Eslam-Abdo/16-bit_microprocessor/ben eater/pc.docx

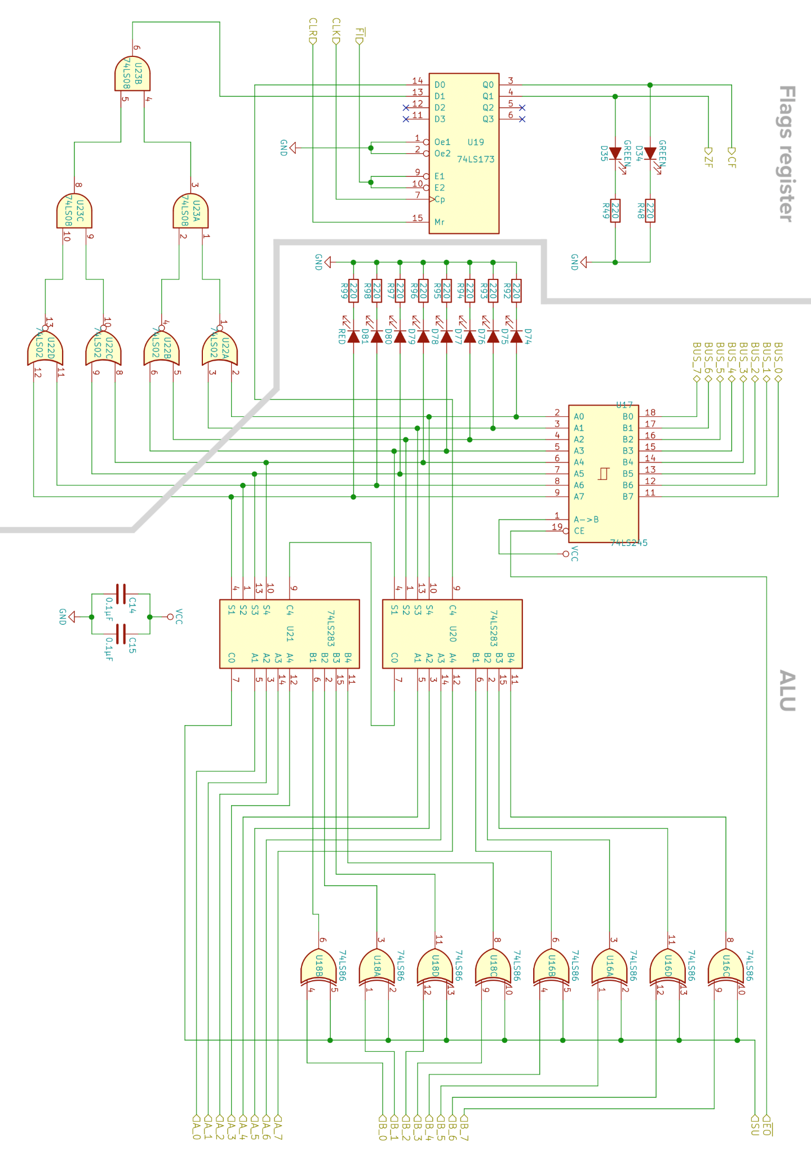
[picture p13: figure]
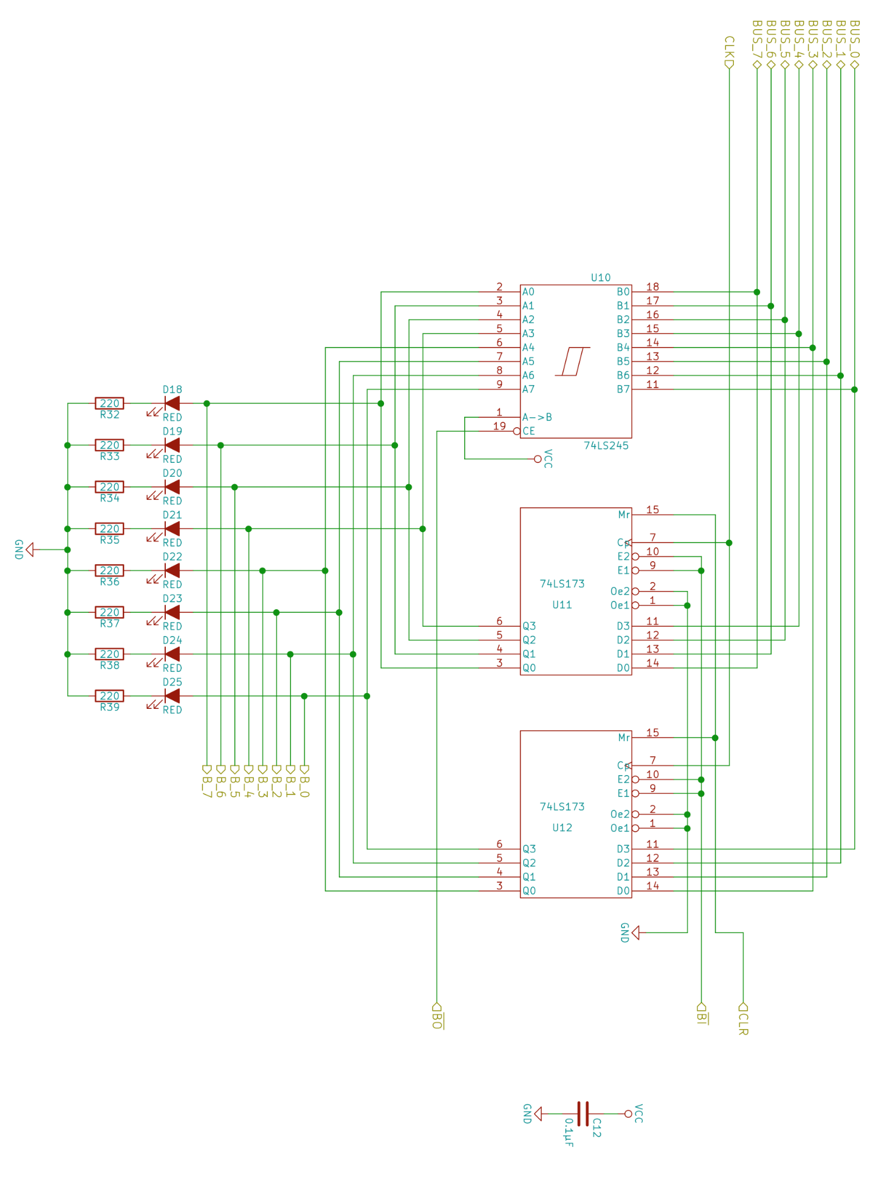
[picture p14: figure]
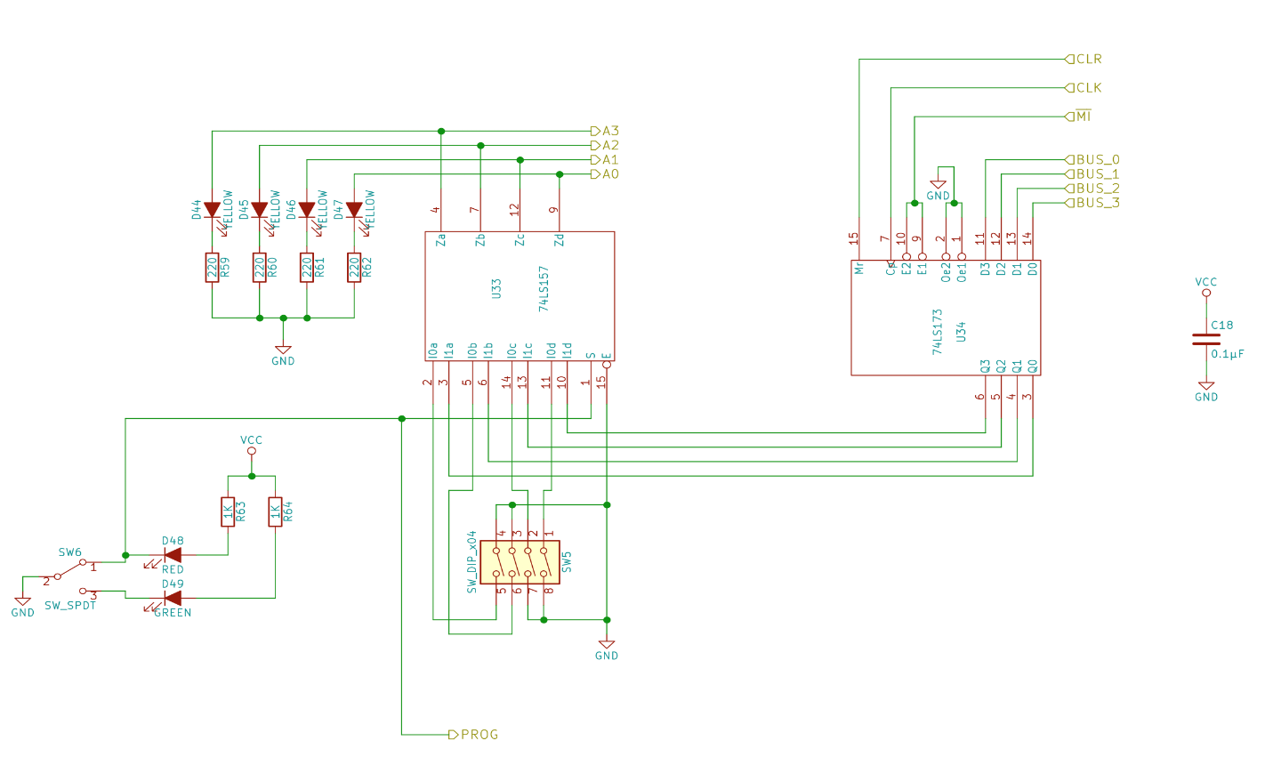
[picture p15: figure]
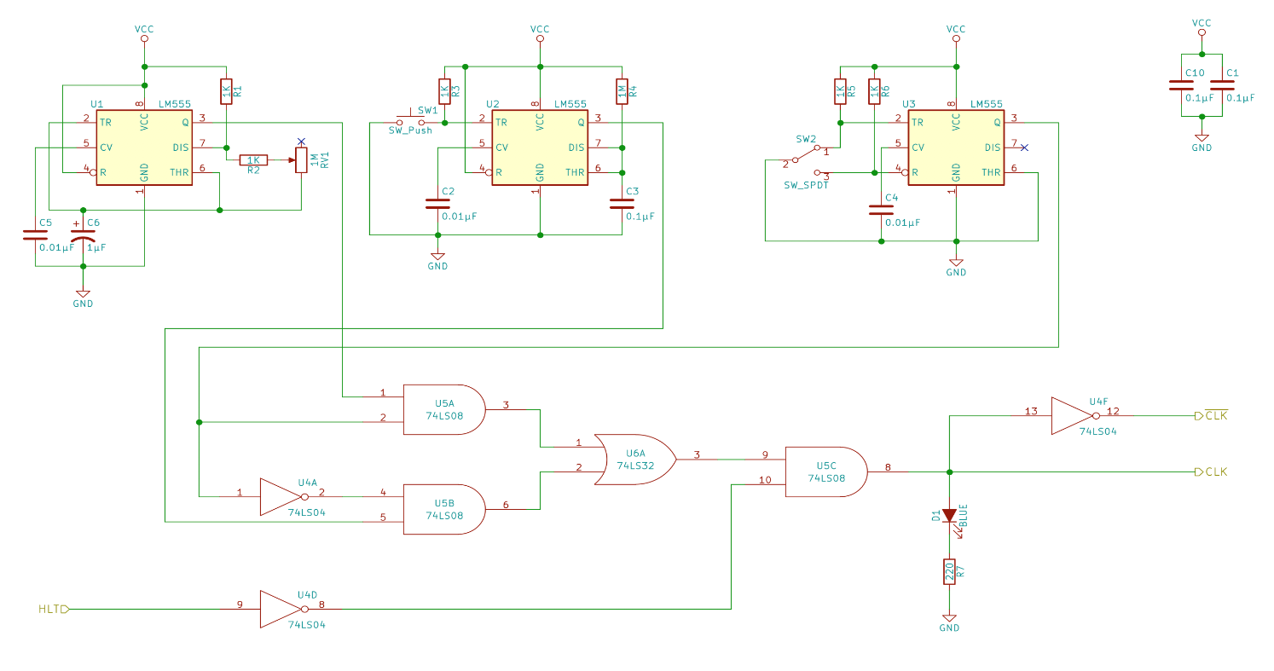
[picture p16: figure]
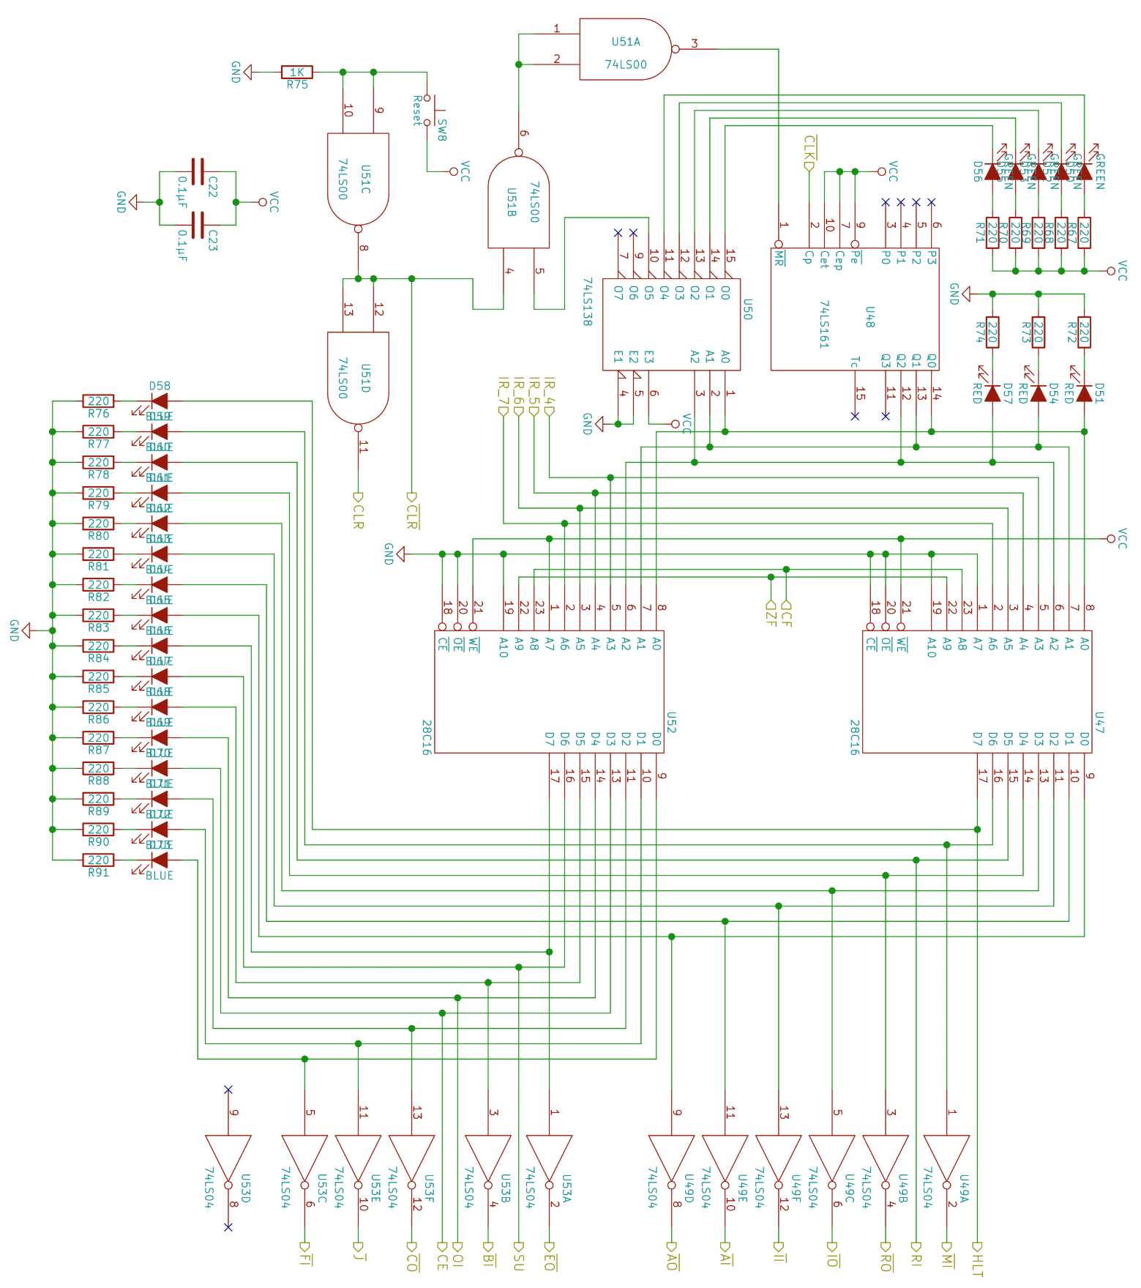
[picture p17: figure]
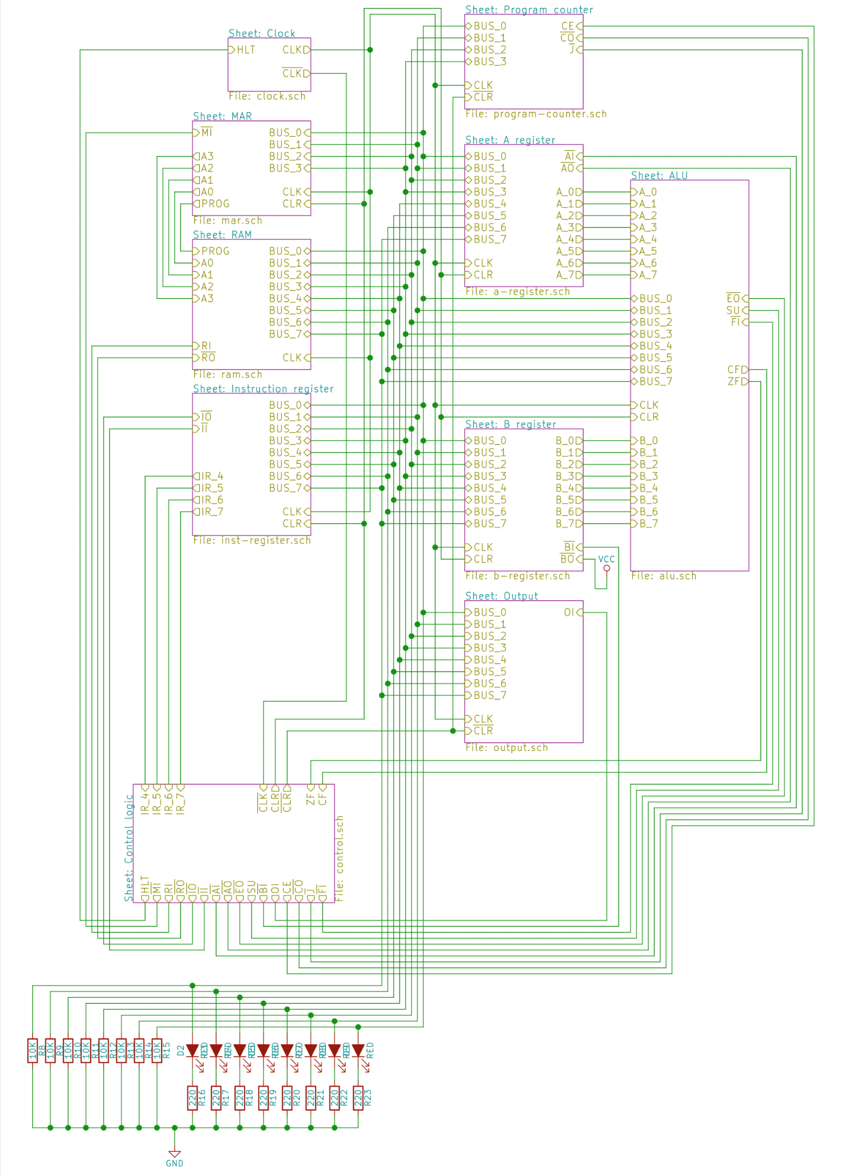
[picture p18: figure]
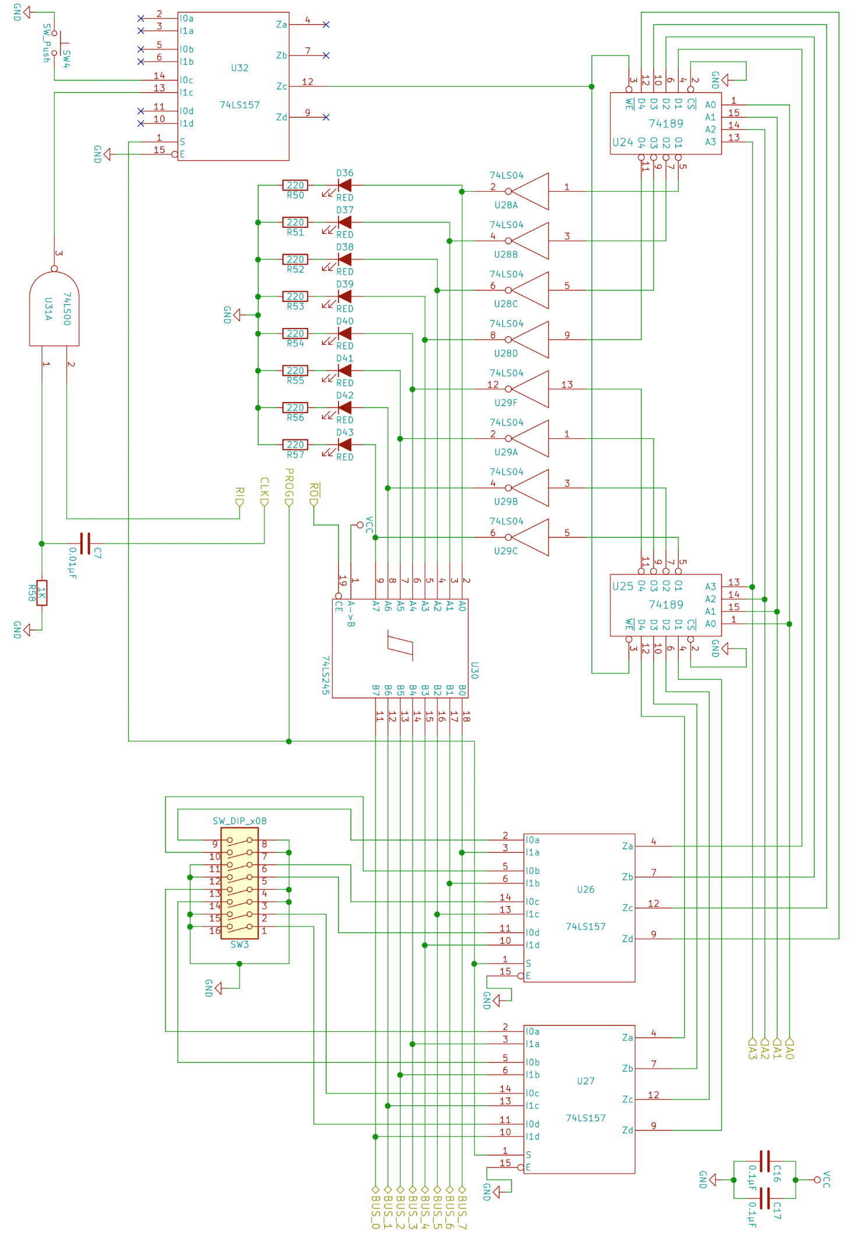
[picture p19: figure]
