Eslam-Abdo/16-bit_microprocessor/PDF/A+B.pdf

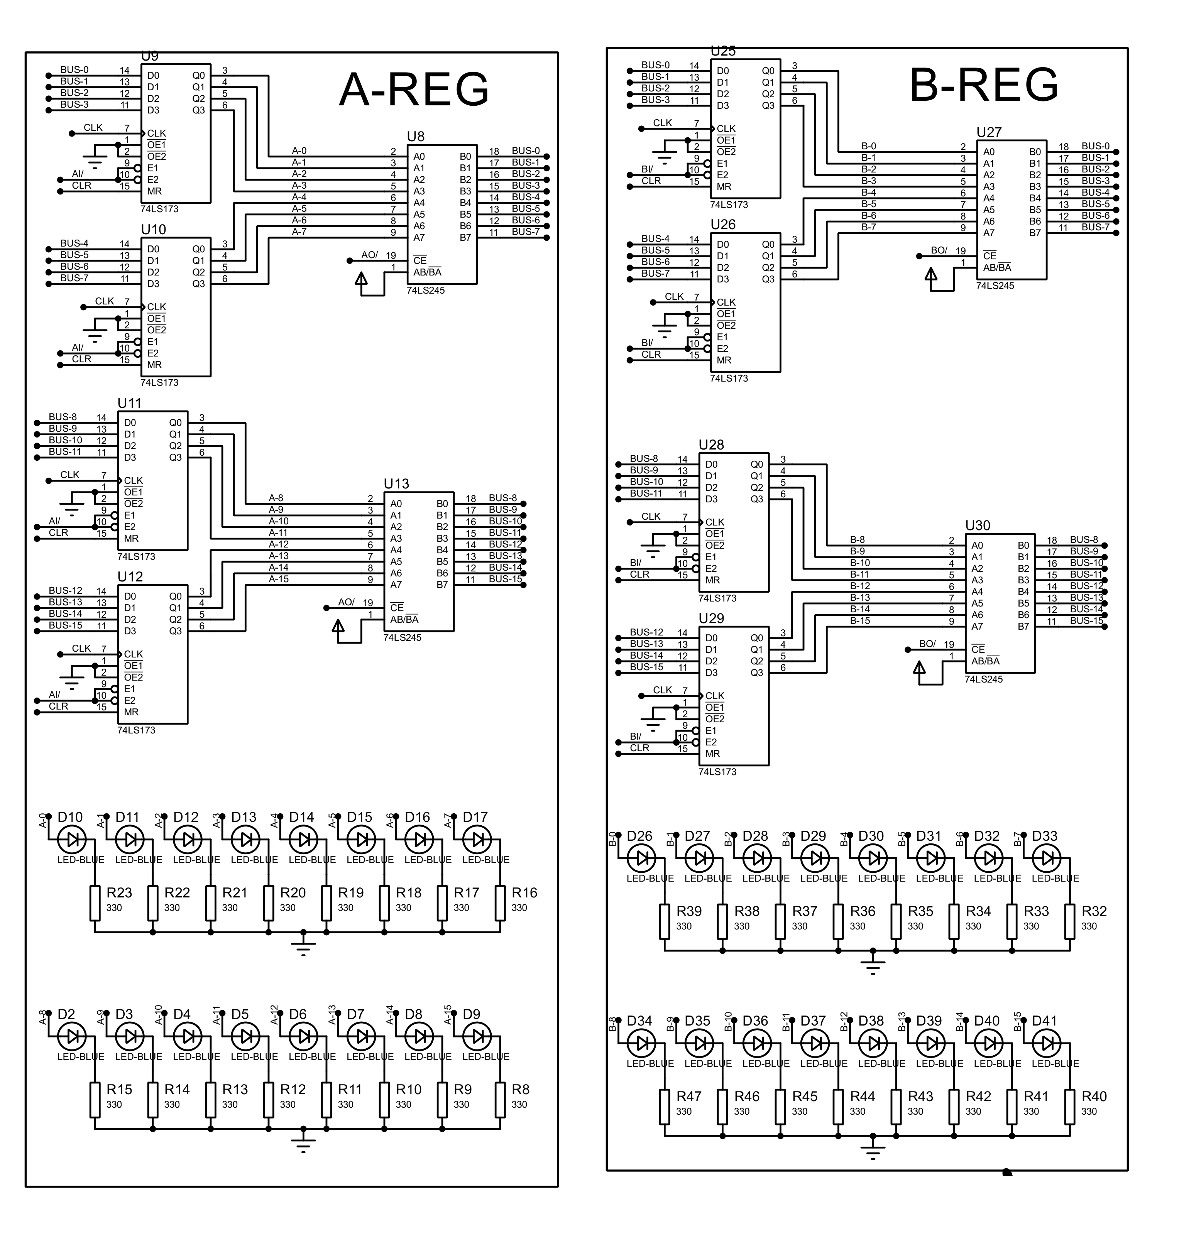
[picture p39: page 1]
