Eslam-Abdo/16-bit_microprocessor/PDF/A-REG.pdf

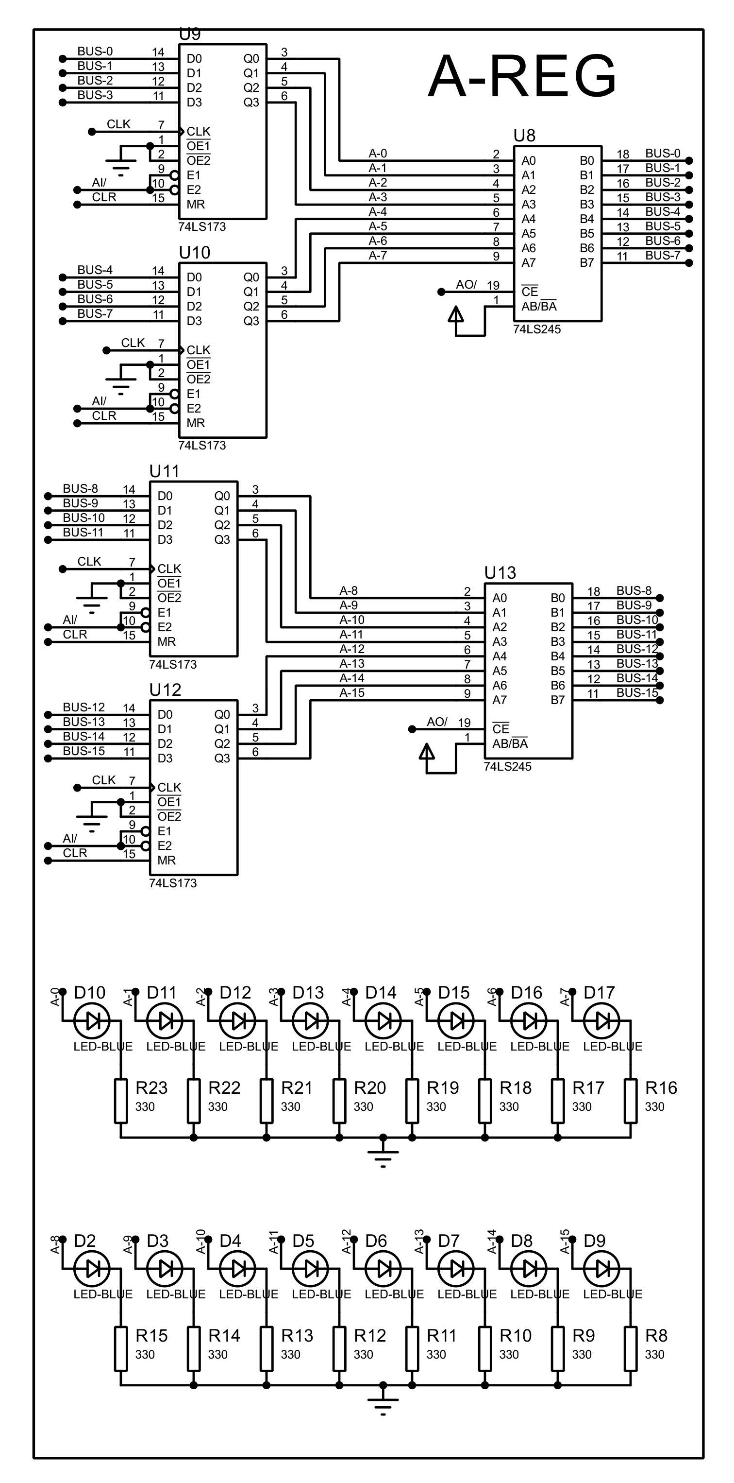
[picture p40: page 1]
