Eslam-Abdo/16-bit_microprocessor/PDF/ALU.pdf

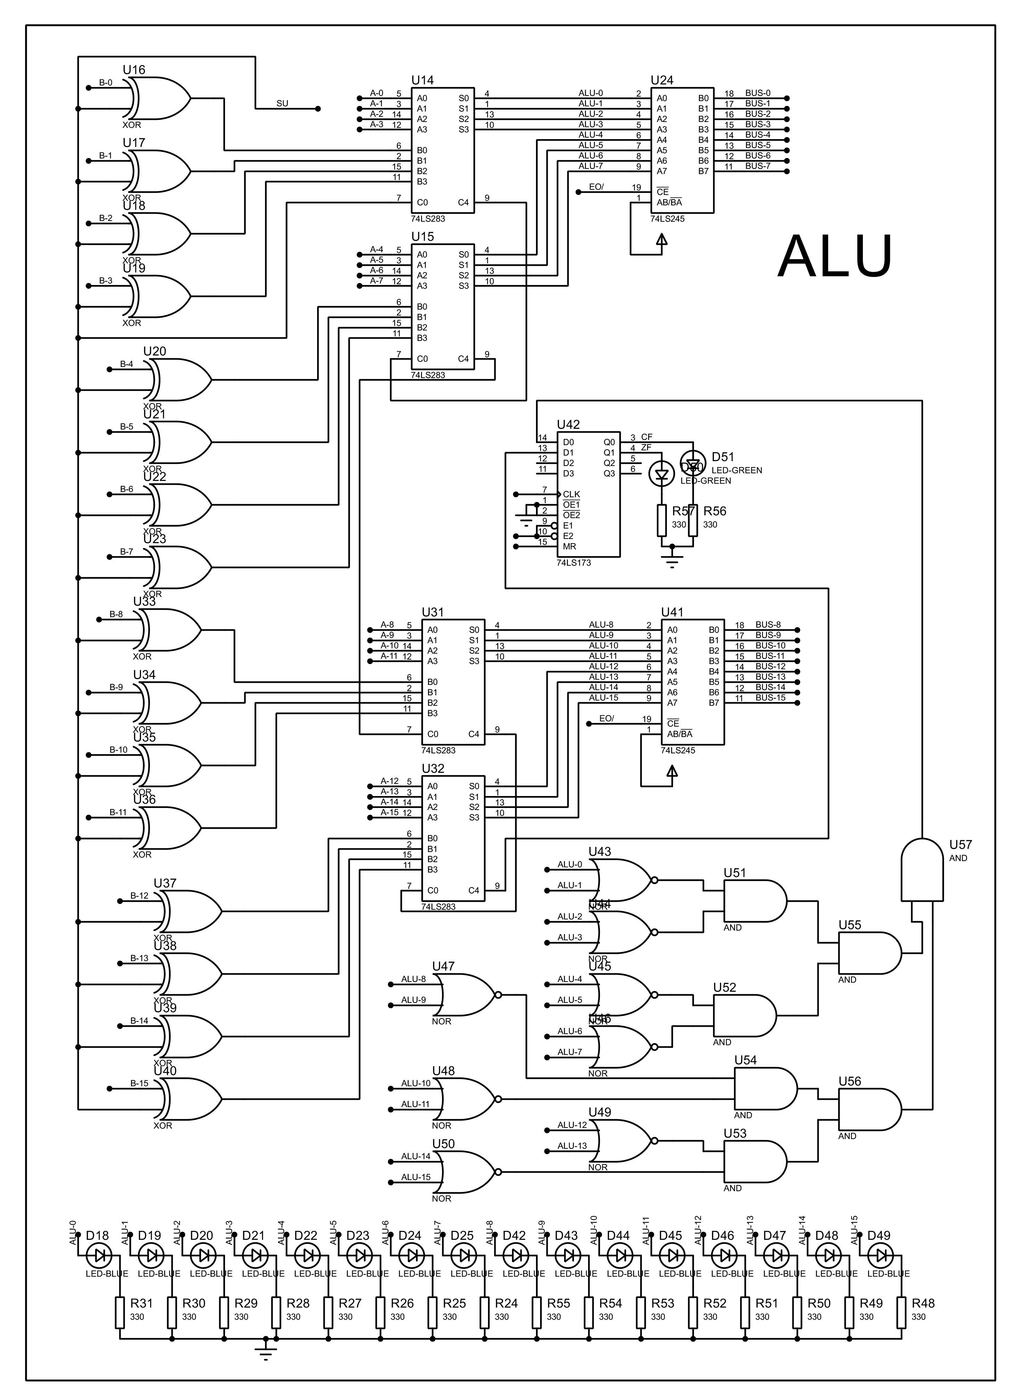
[picture p41: page 1]
