Eslam-Abdo/16-bit_microprocessor/PDF/B-REG.pdf

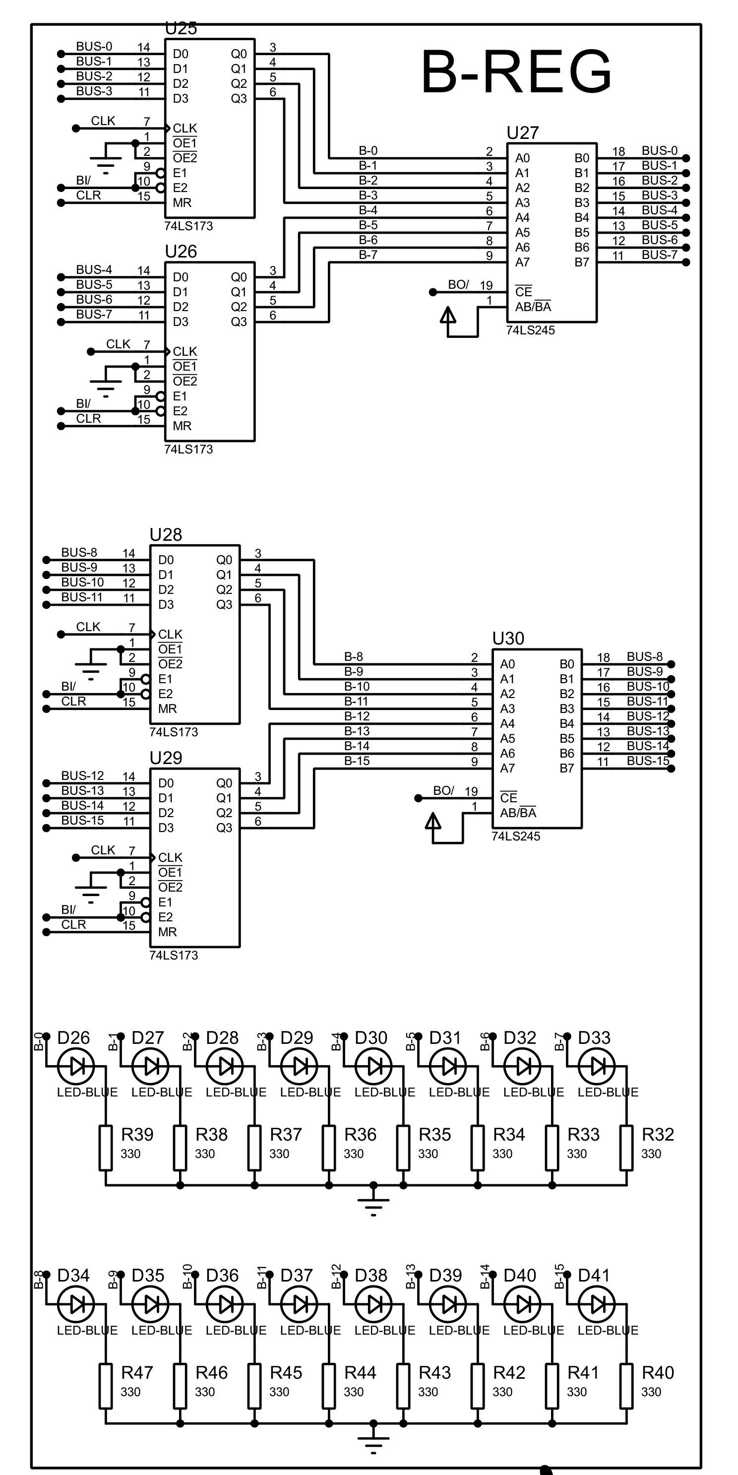
[picture p42: page 1]
