Eslam-Abdo/16-bit_microprocessor/PDF/BUS.pdf

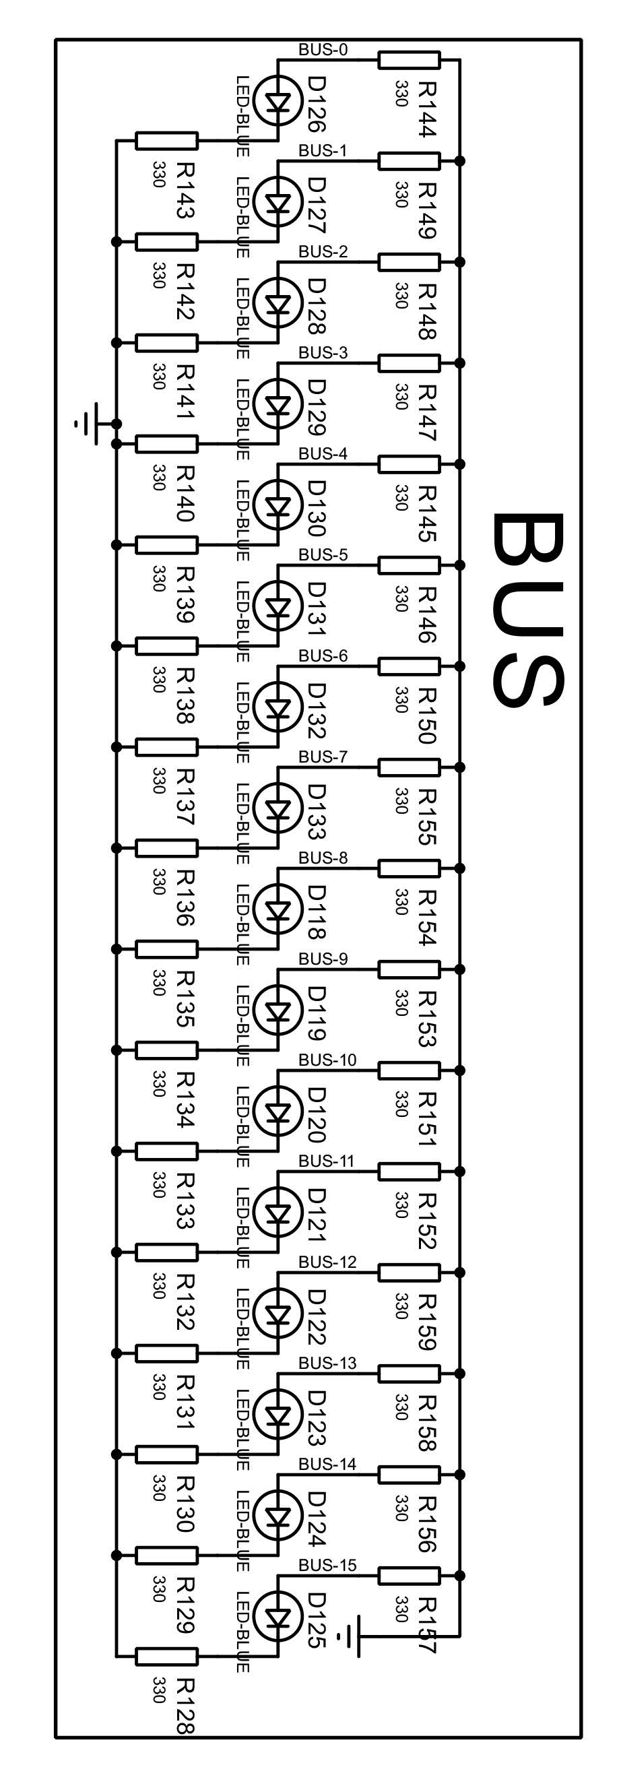
[picture p43: page 1]
