Eslam-Abdo/16-bit_microprocessor/PDF/cl+bus.pdf

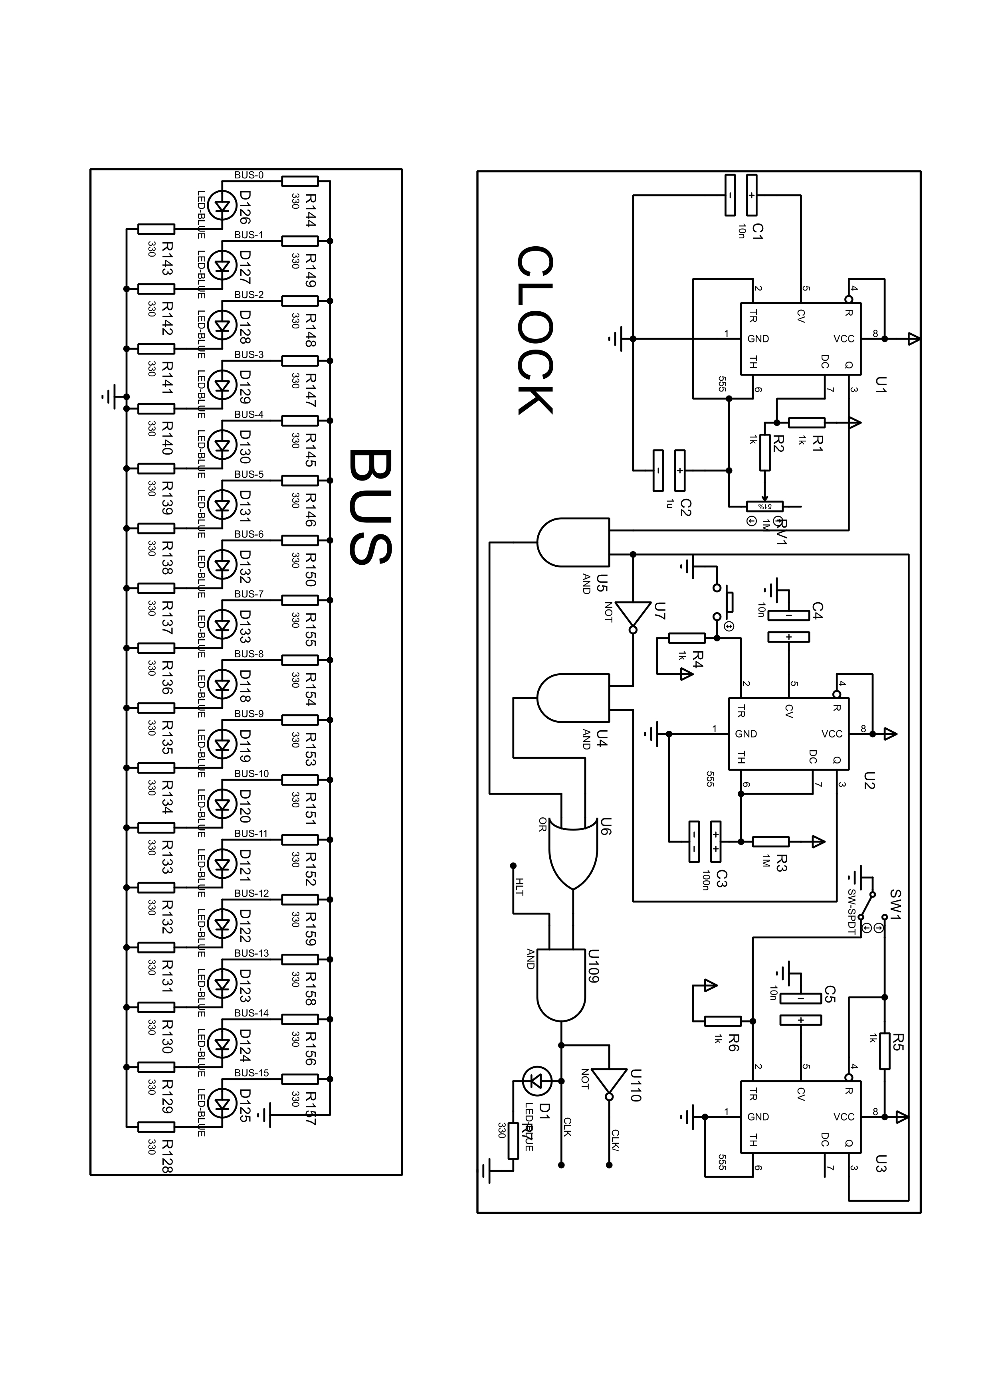
[picture p44: page 1]
