Eslam-Abdo/16-bit_microprocessor/PDF/clock.pdf

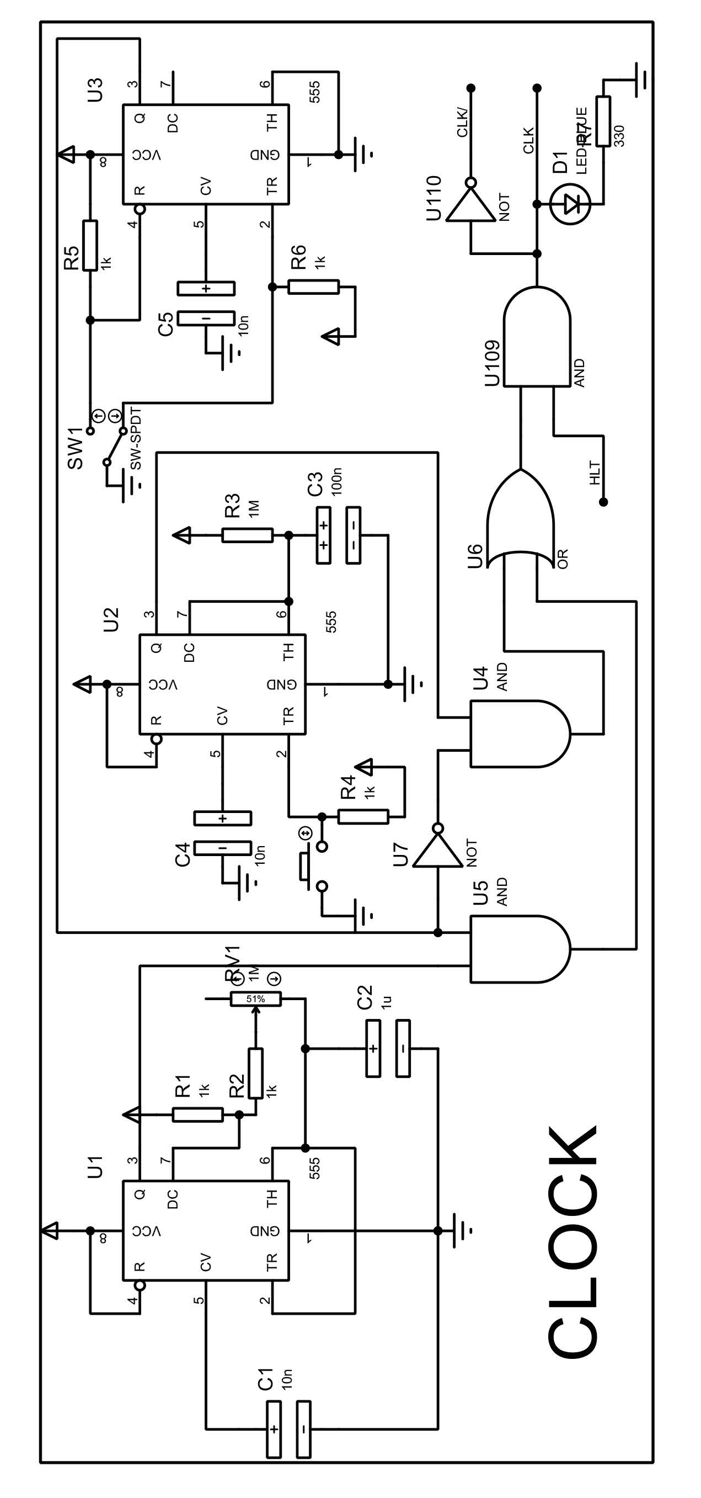
[picture p45: page 1]
