Eslam-Abdo/16-bit_microprocessor/PDF/contral logic.pdf

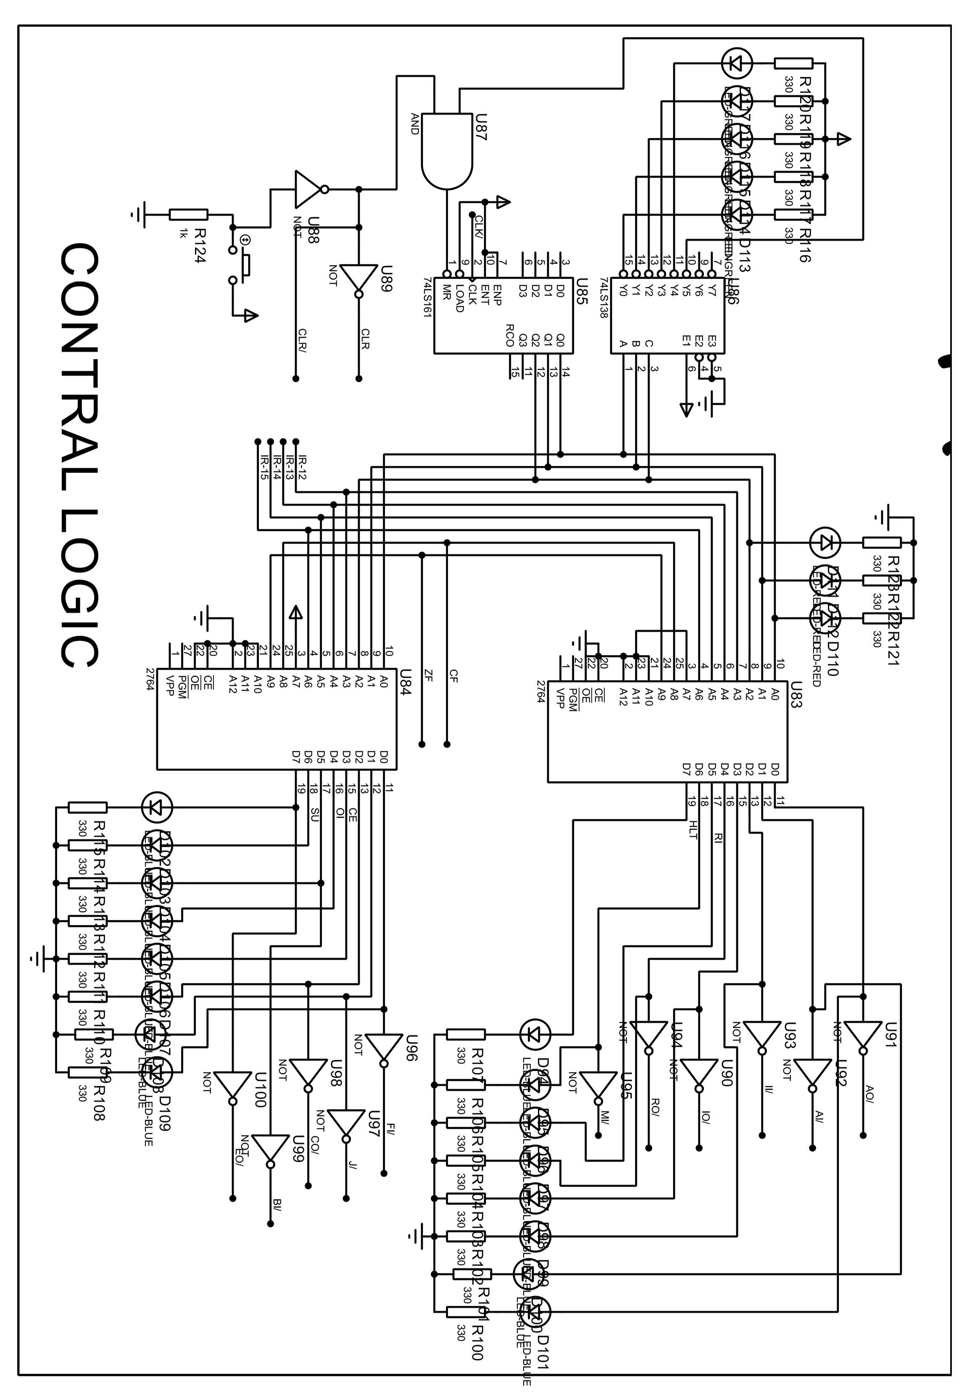
[picture p46: page 1]
