Eslam-Abdo/16-bit_microprocessor/PDF/I-REG.pdf

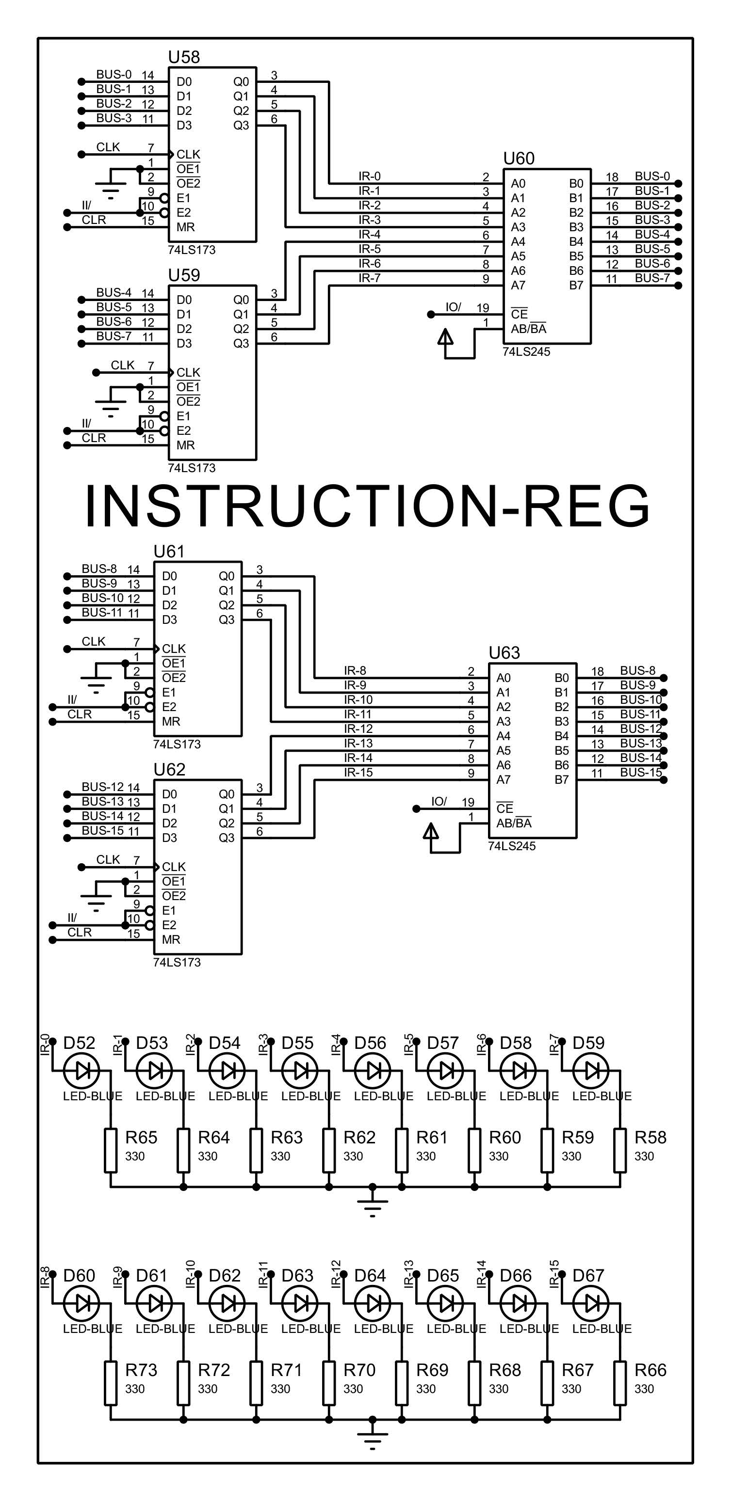
[picture p47: page 1]
