Eslam-Abdo/16-bit_microprocessor/PDF/IR+COUNTER.pdf

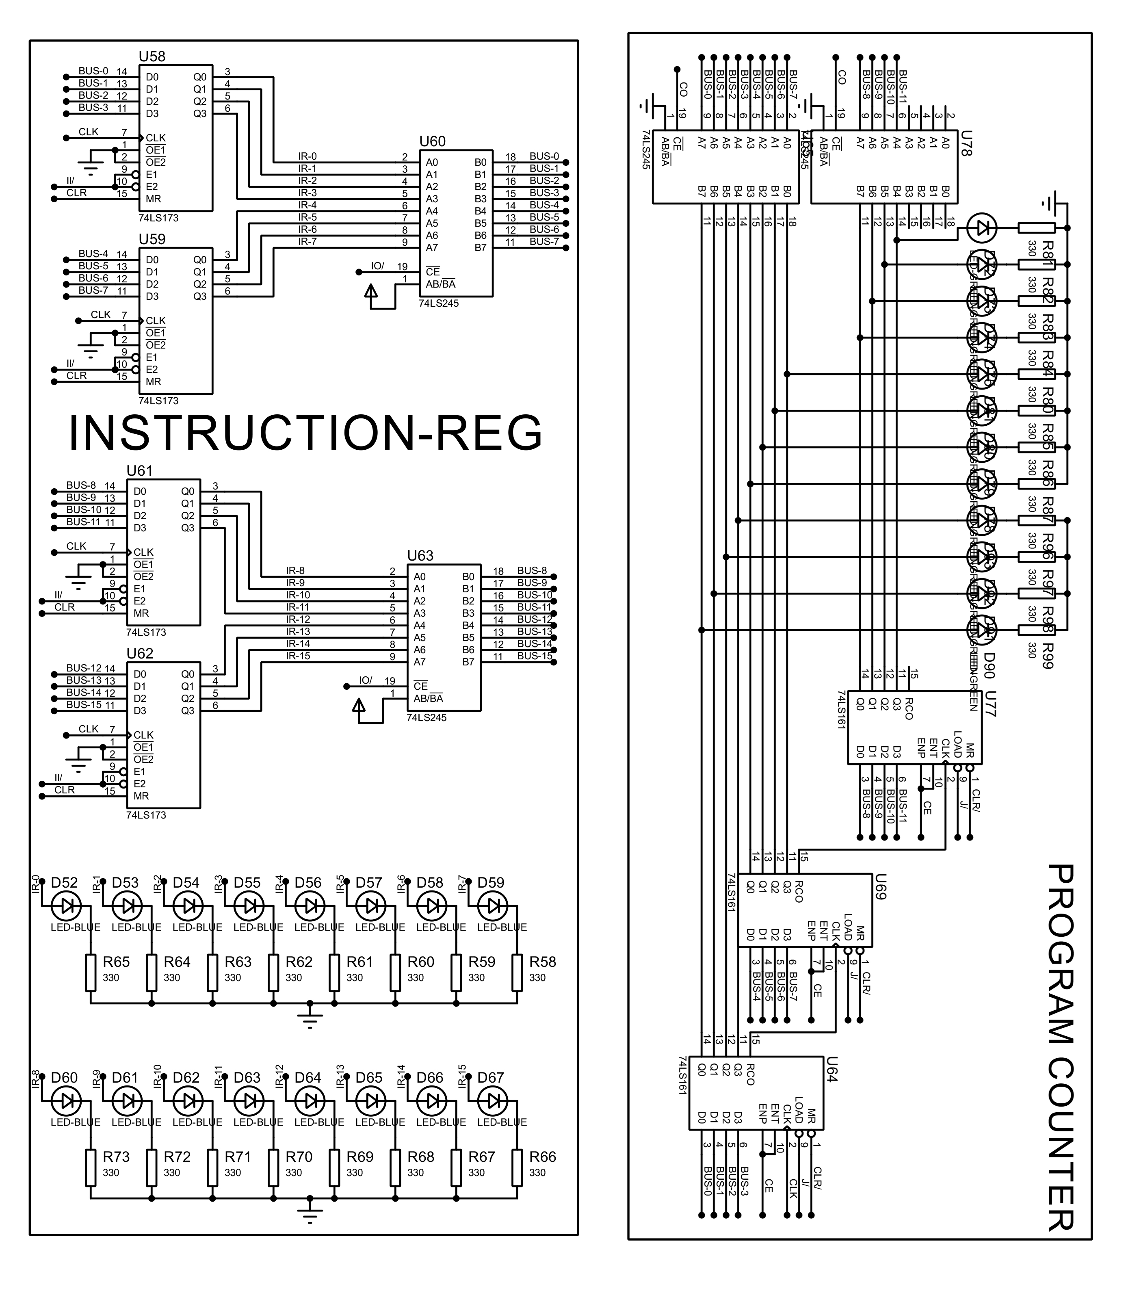
[picture p48: page 1]
