Eslam-Abdo/16-bit_microprocessor/PDF/MAR.pdf

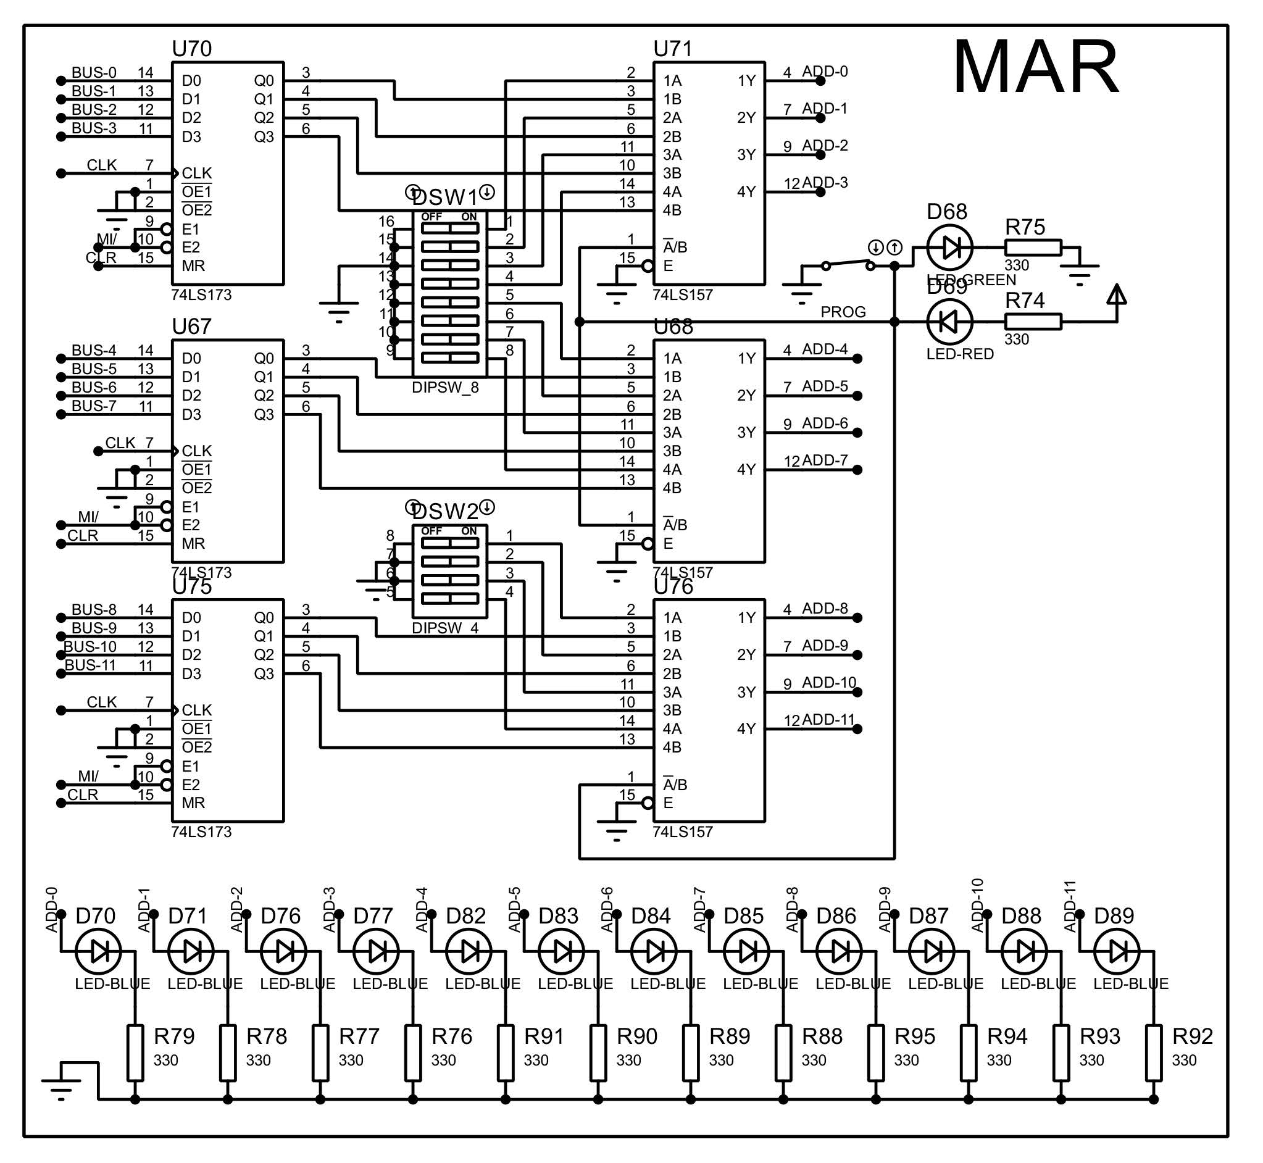
[picture p49: page 1]
