Eslam-Abdo/16-bit_microprocessor/PDF/O+CPU.pdf

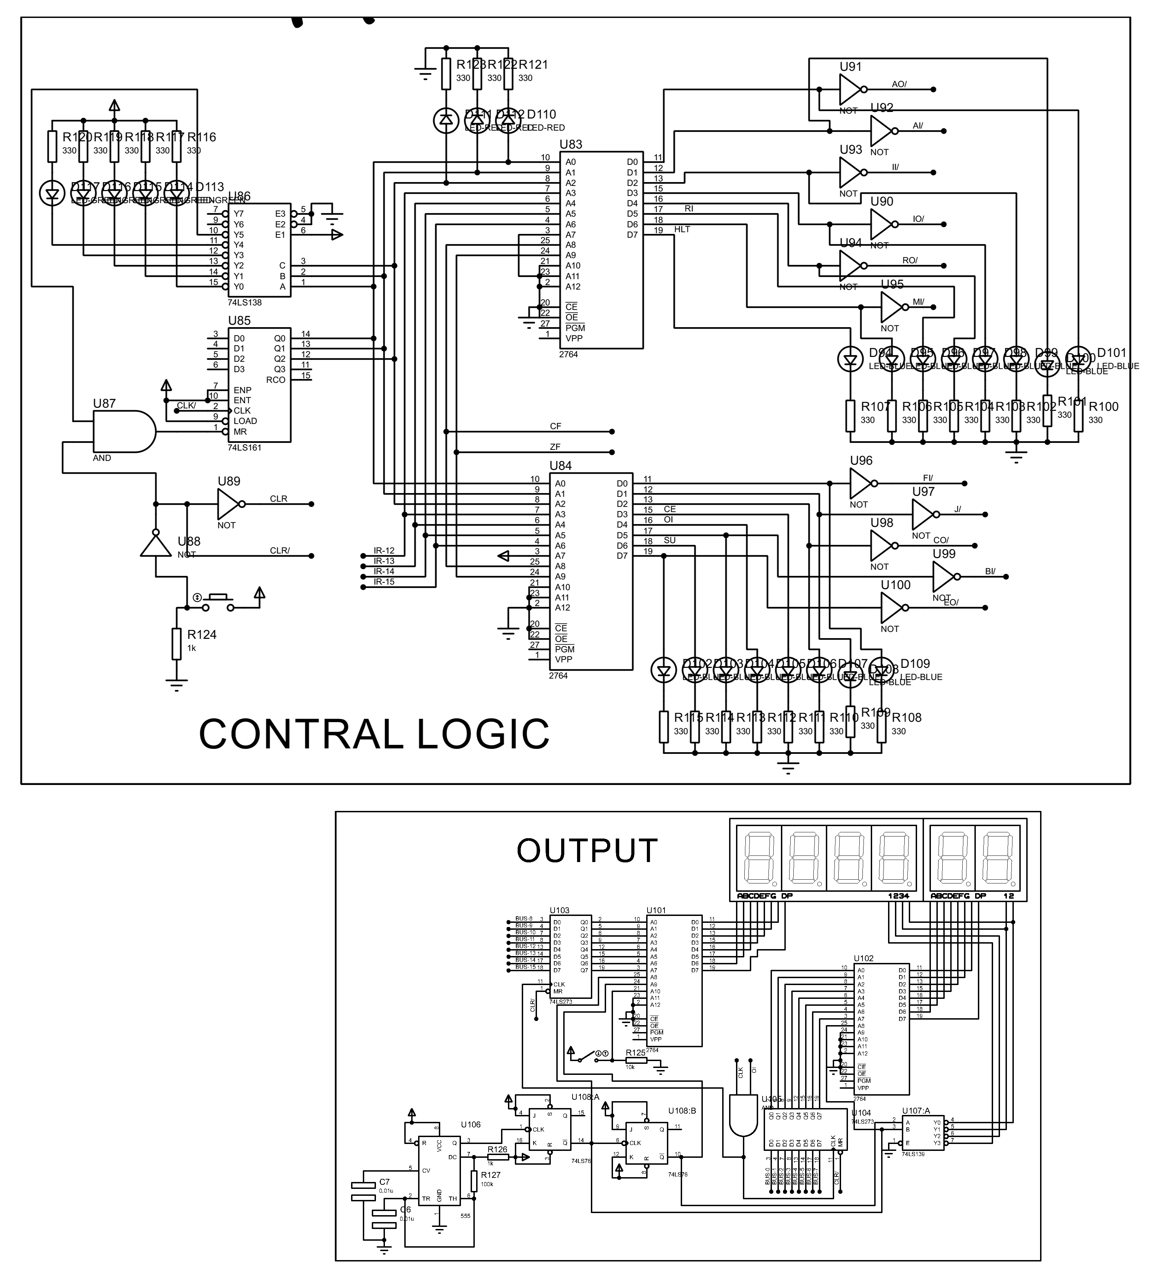
[picture p50: page 1]
