Eslam-Abdo/16-bit_microprocessor/PDF/OUTPUT.pdf

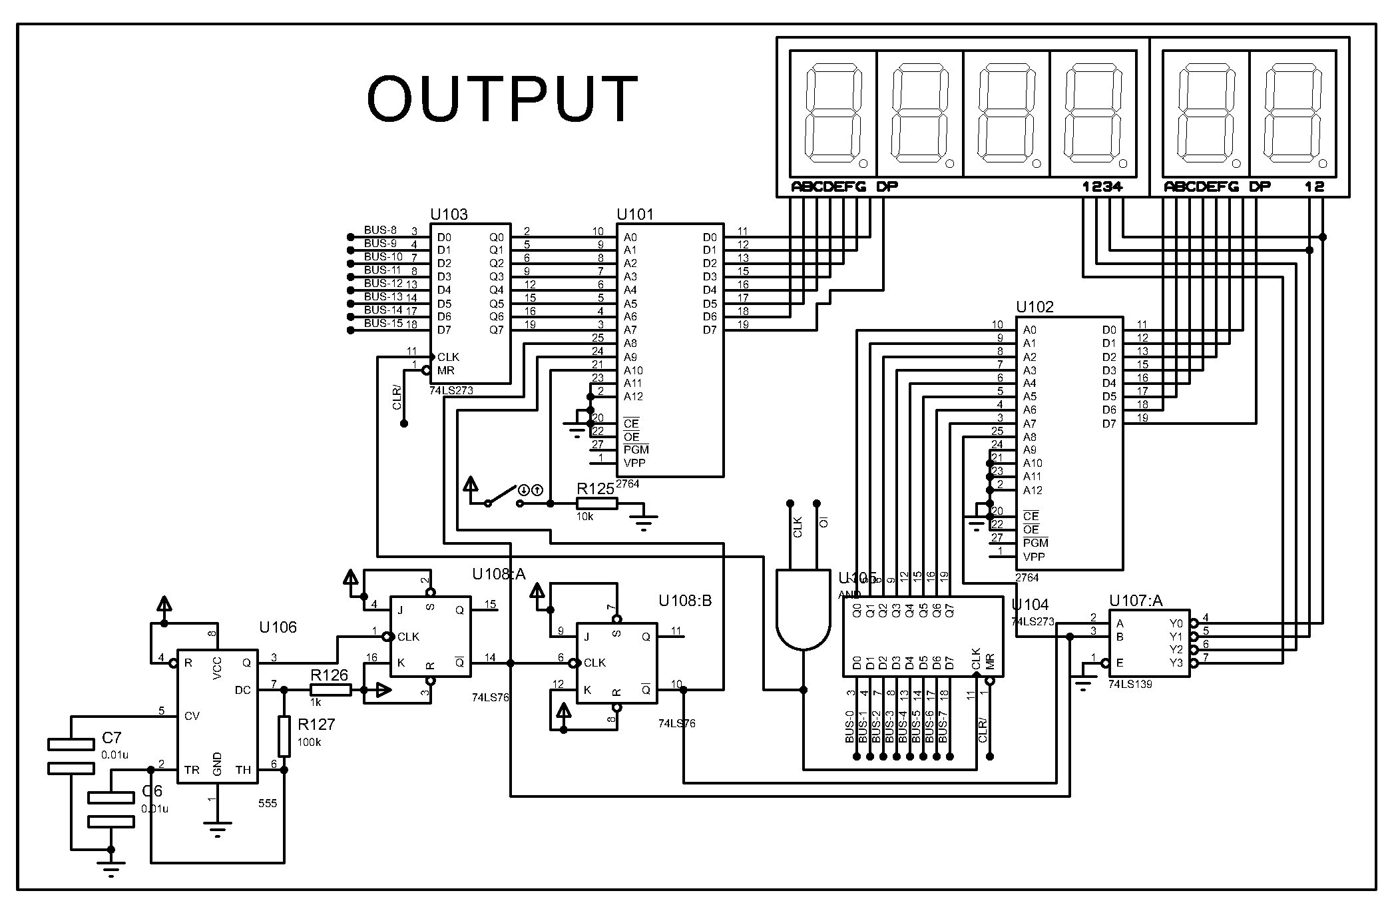
[picture p51: page 1]
