Eslam-Abdo/16-bit_microprocessor/PDF/program counter.pdf

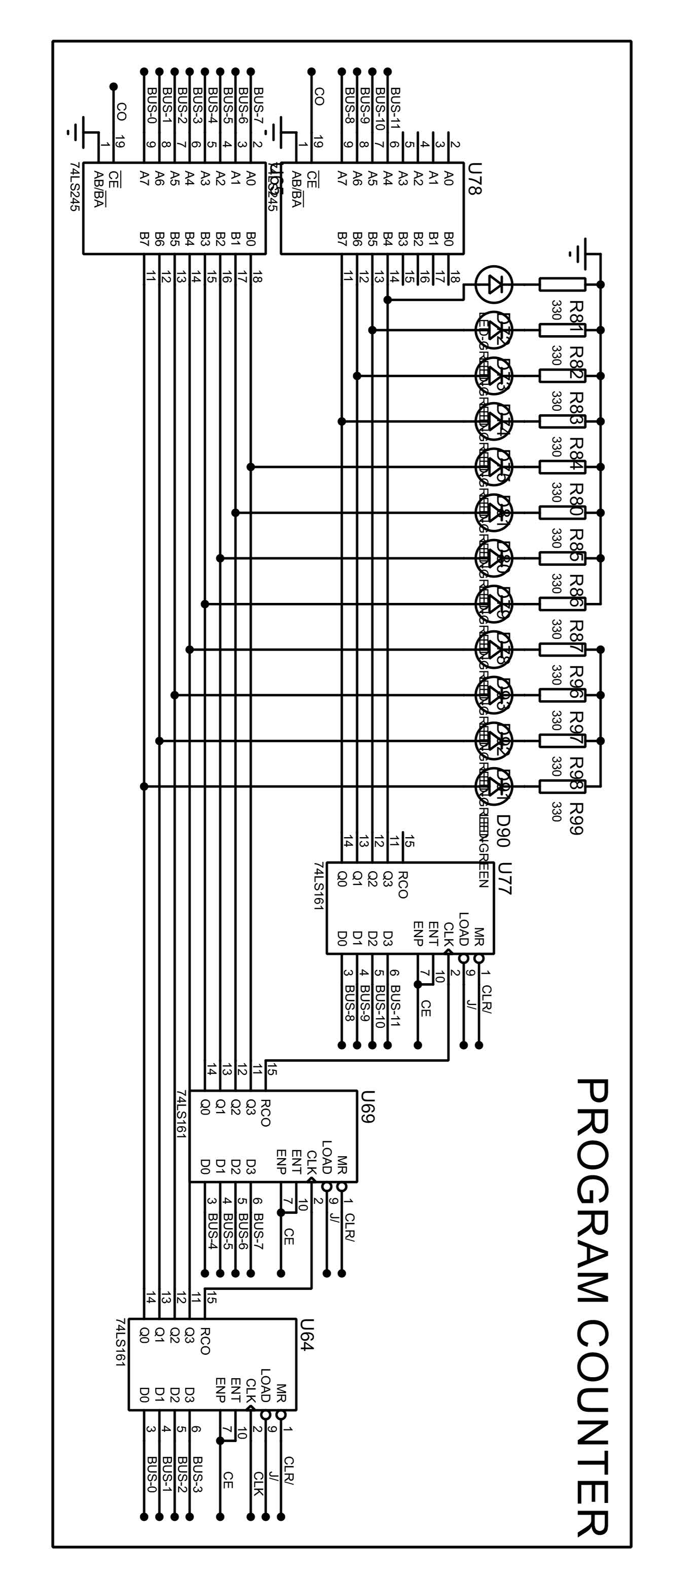
[picture p52: page 1]
