Eslam-Abdo/16-bit_microprocessor/PDF/RAM+aDD.pdf

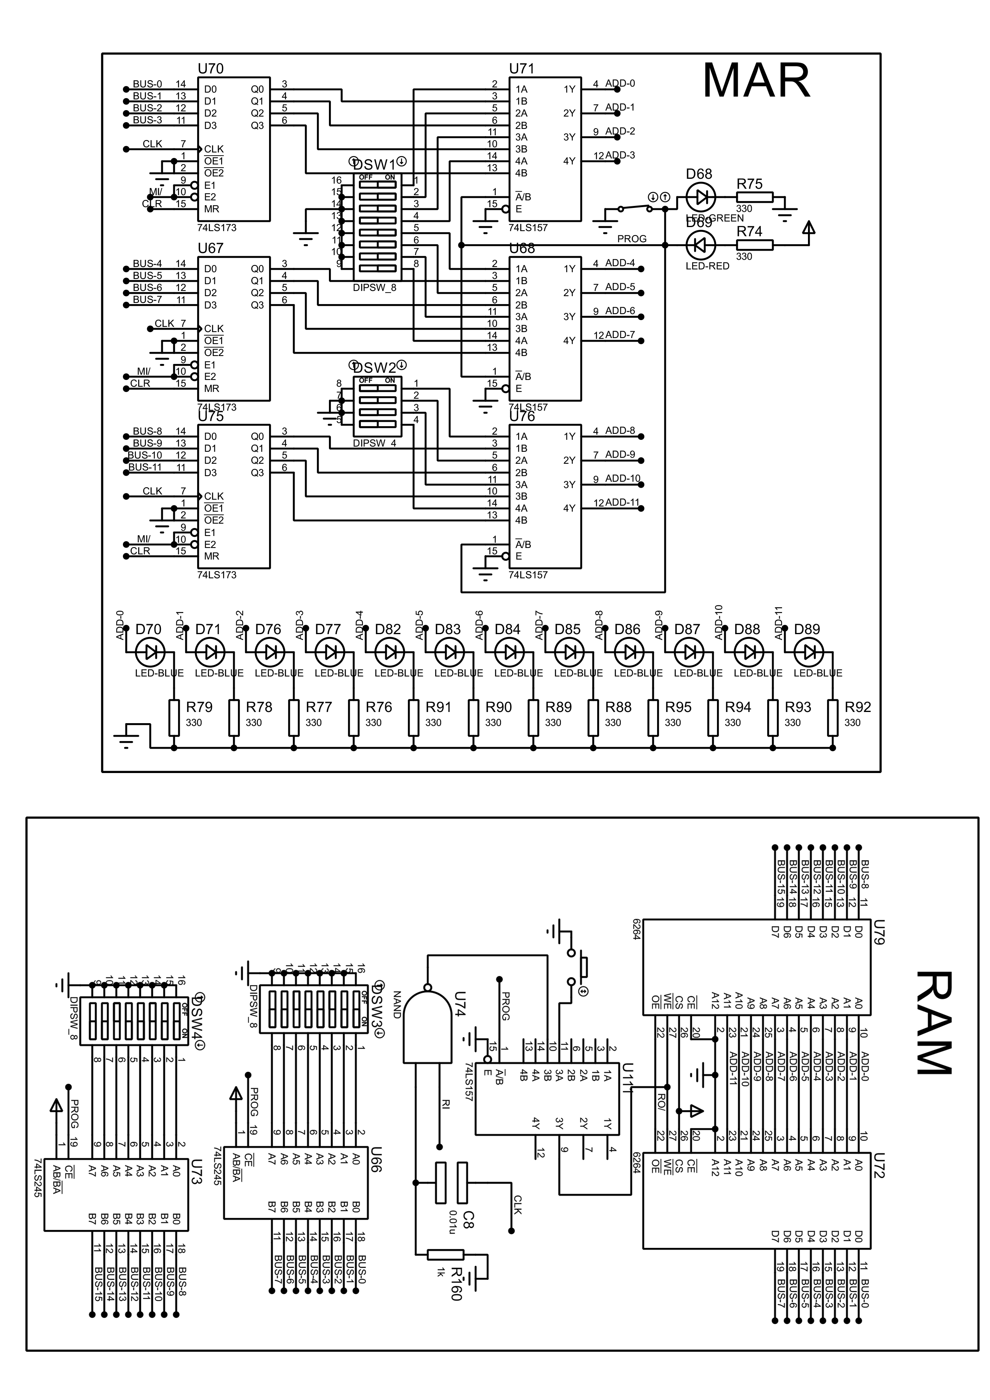
[picture p53: page 1]
