Eslam-Abdo/16-bit_microprocessor/PDF/RAM.pdf

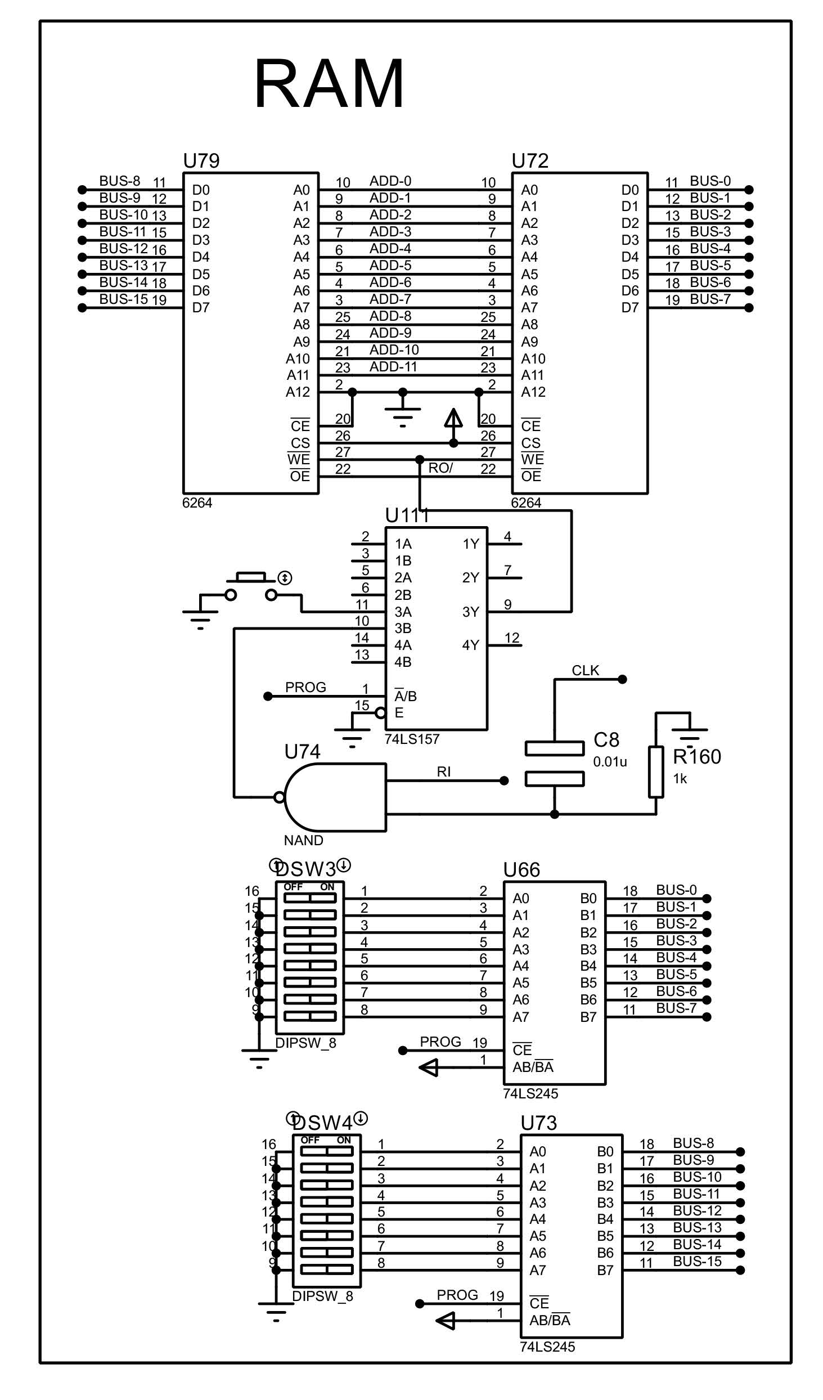
[picture p54: page 1]
