Eslam-Abdo/16-bit_microprocessor/ben eater/alu.png

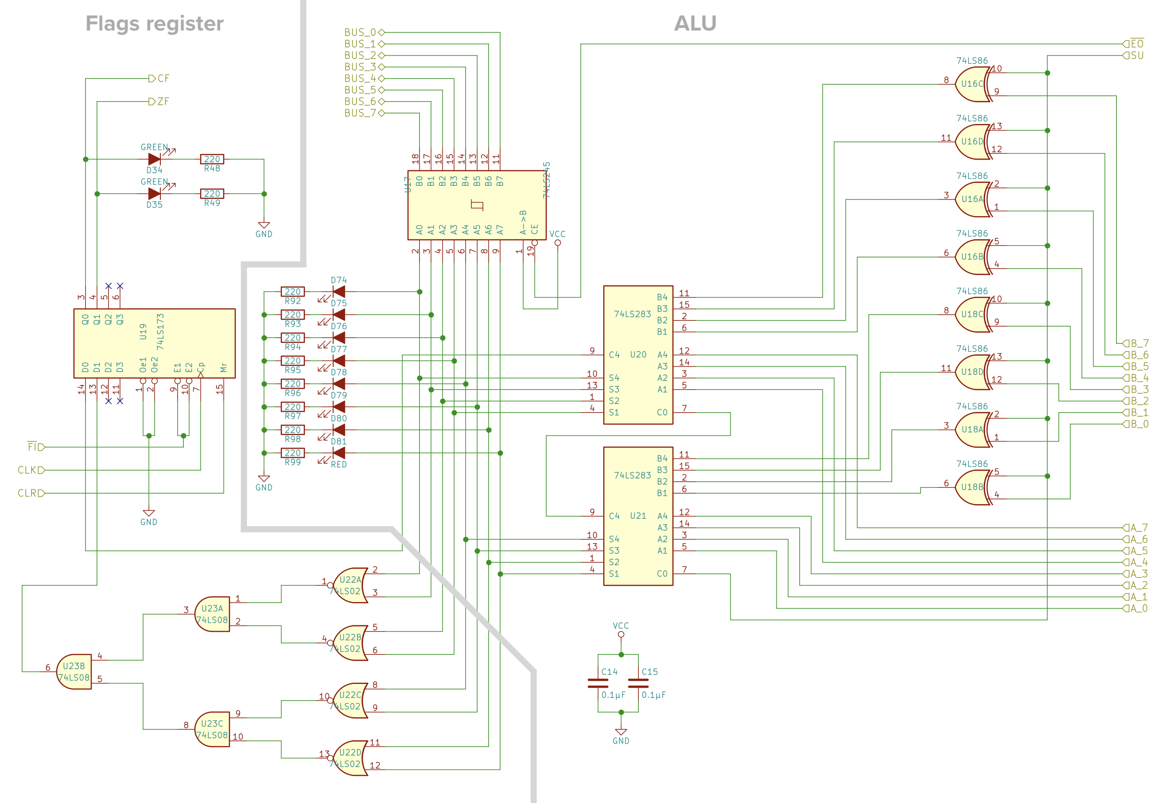
ben eater/alu.png
