Eslam-Abdo/16-bit_microprocessor/ben eater/b-register.png

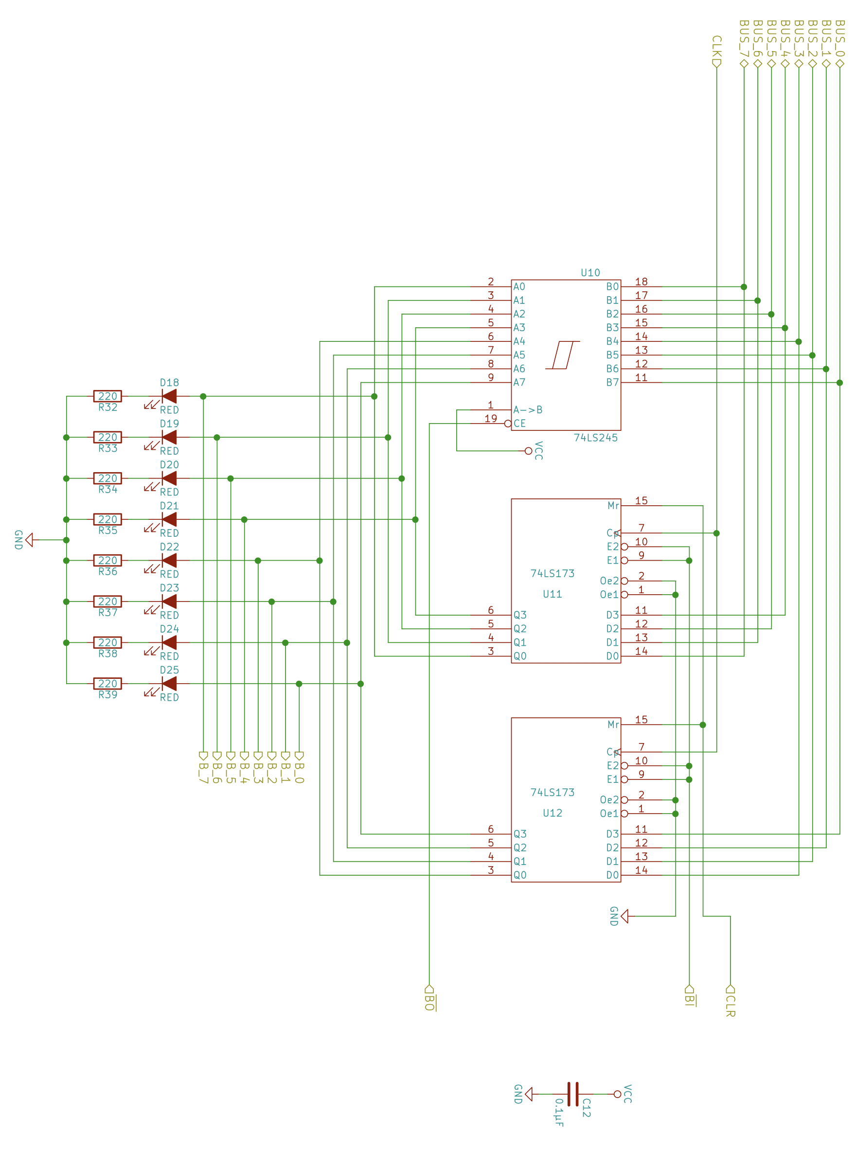
ben eater/b-register.png
