Eslam-Abdo/16-bit_microprocessor/ben eater/control.png

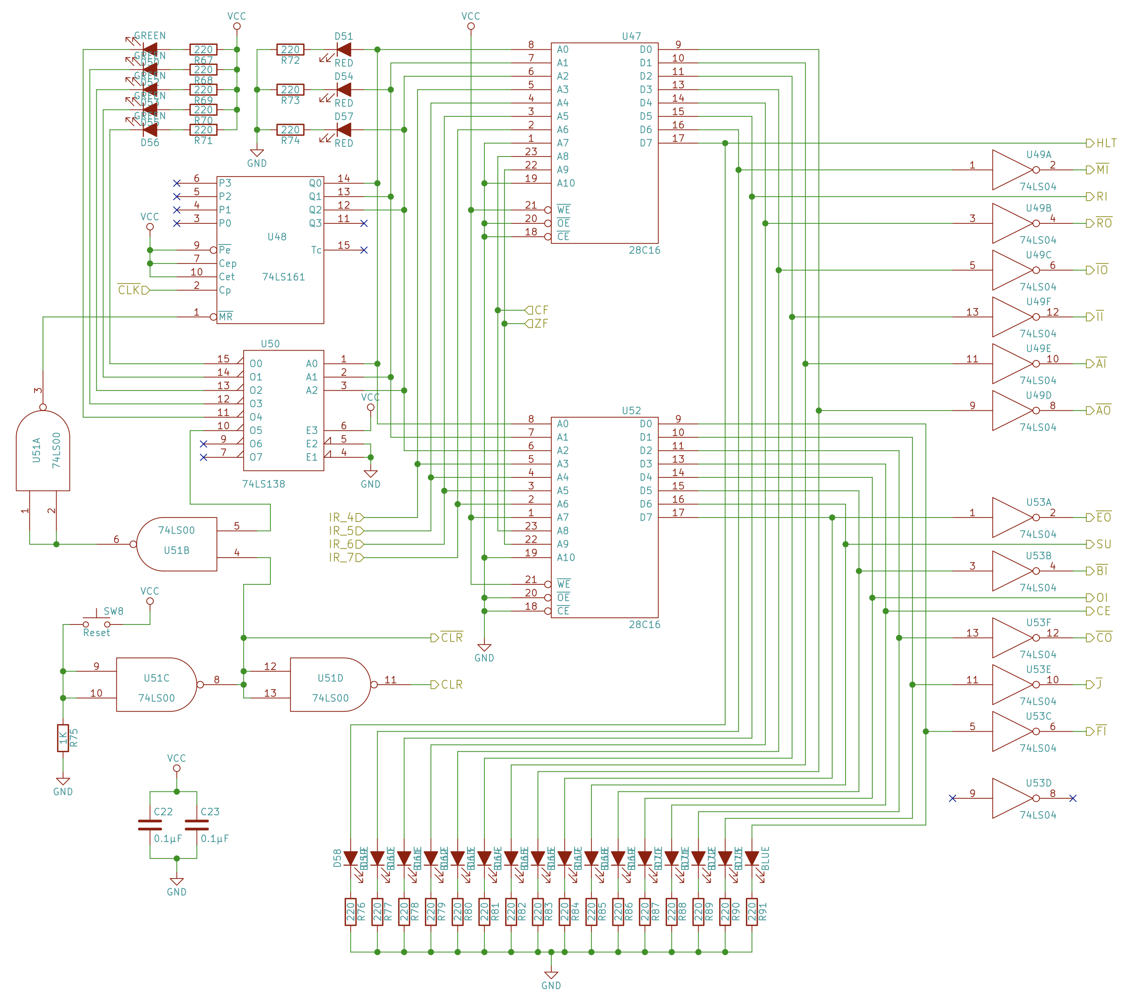
ben eater/control.png
