Eslam-Abdo/16-bit_microprocessor/ben eater/output.png

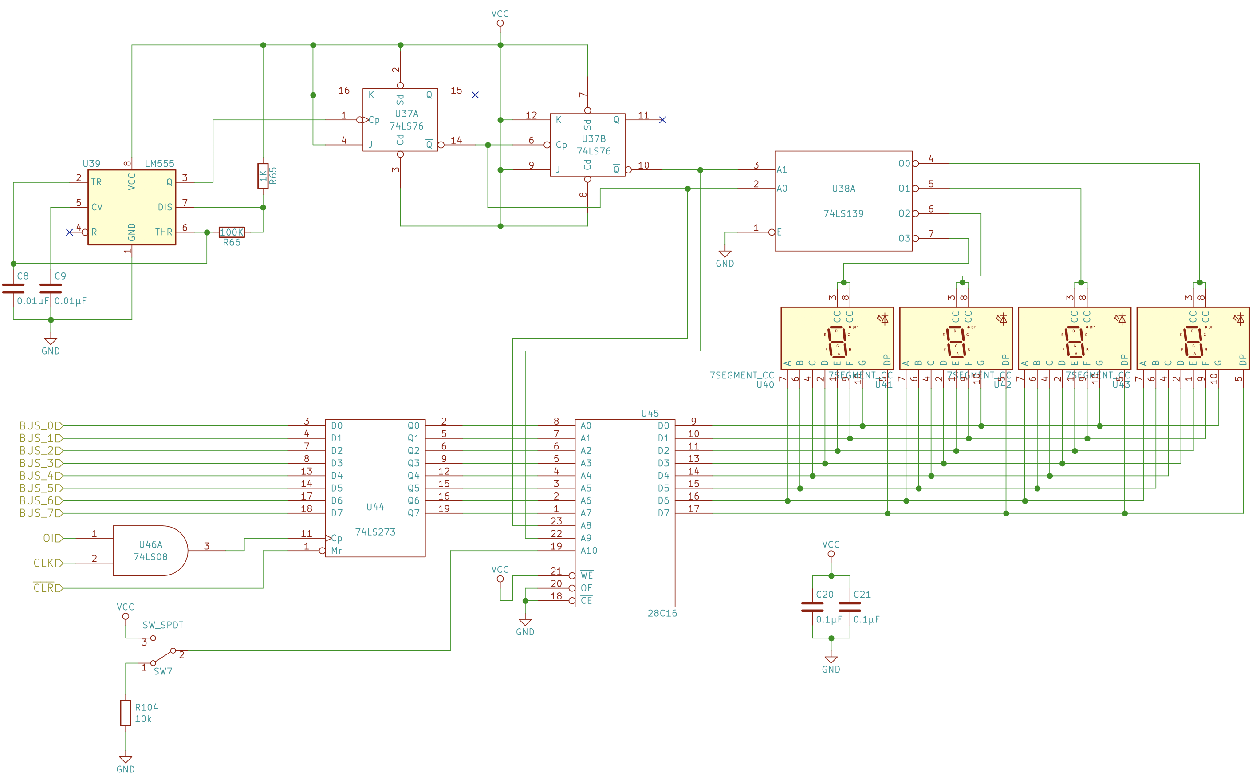
ben eater/output.png
