Eslam-Abdo/16-bit_microprocessor/ben eater/pc.png

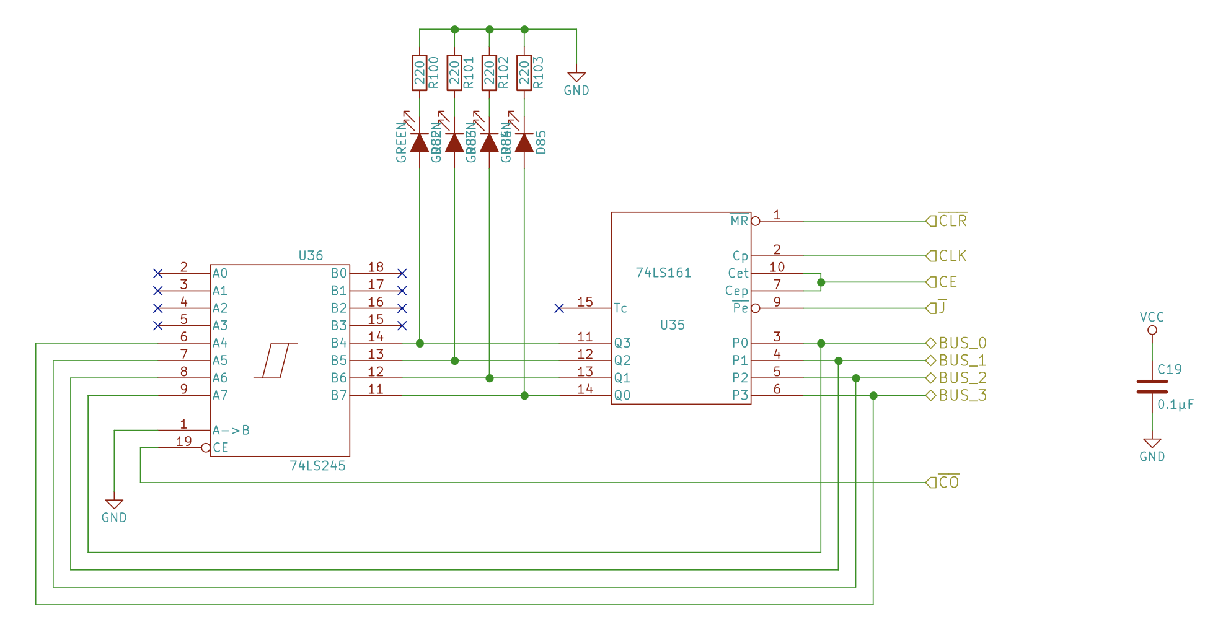
ben eater/pc.png
