Eslam-Abdo/16-bit_microprocessor/ben eater/ram.png

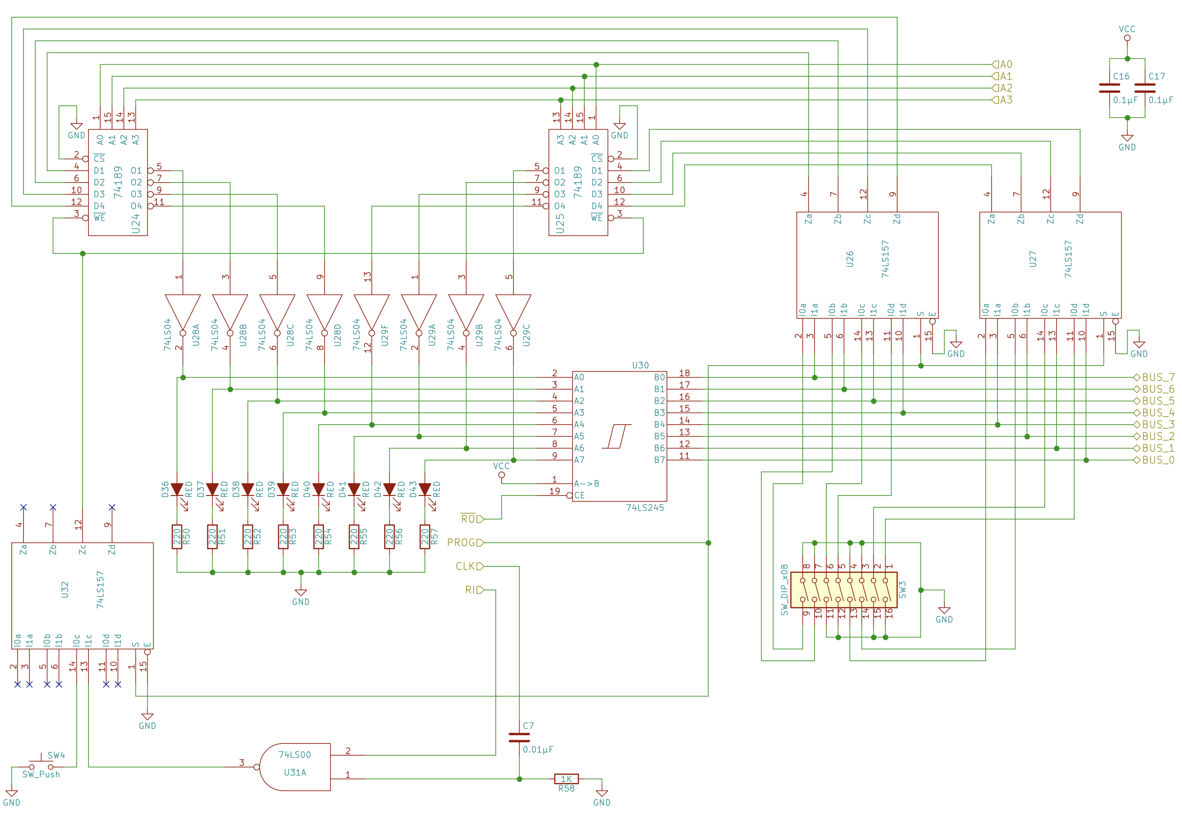
ben eater/ram.png
