Eslam-Abdo/16-bit_microprocessor/PDF/contral logic.png

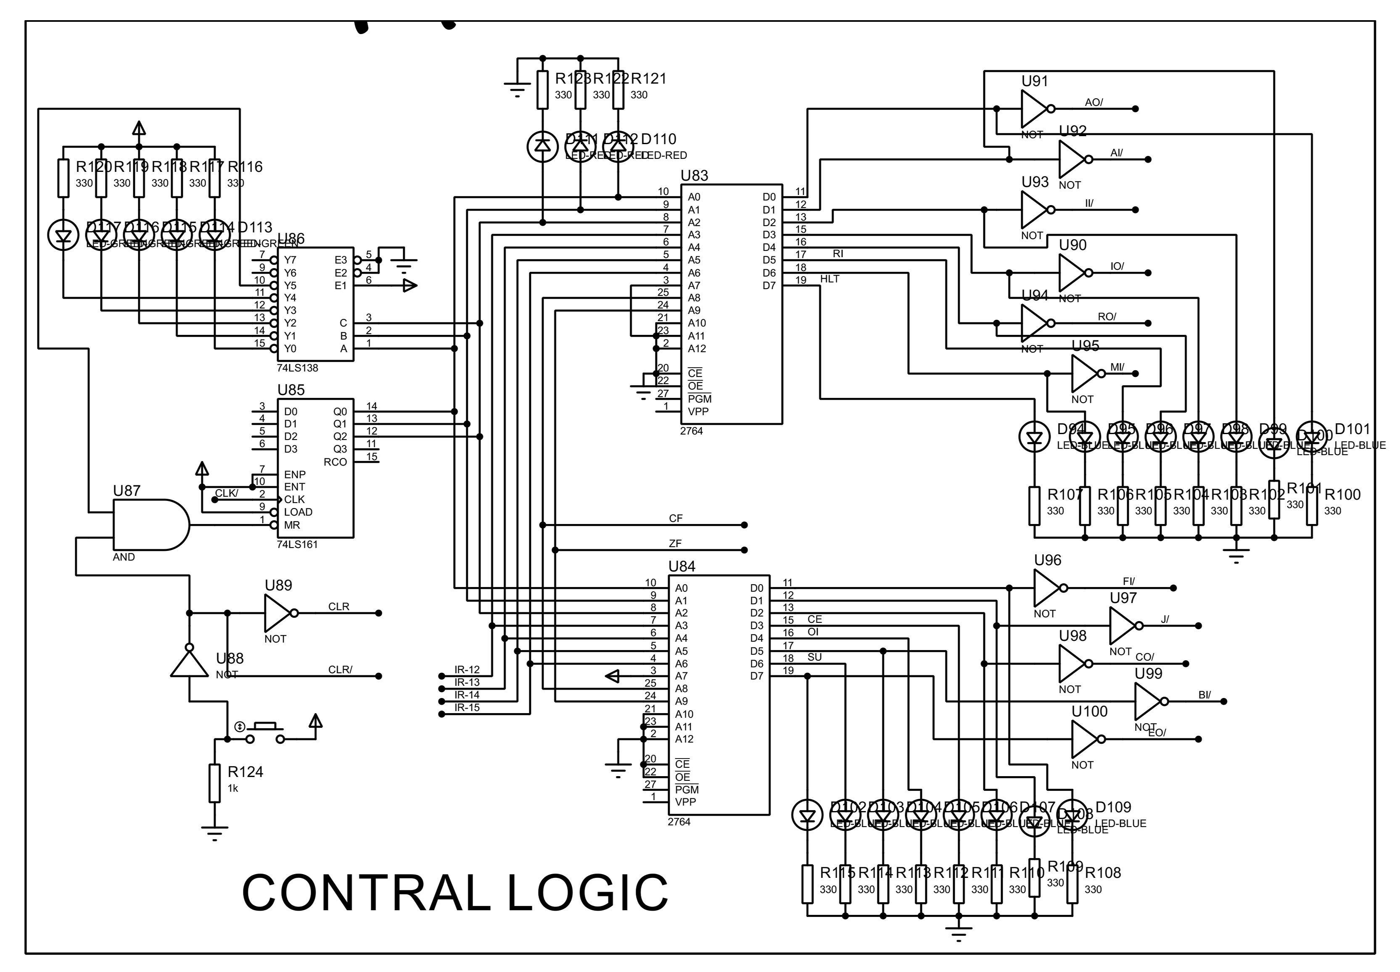
PDF/contral logic.png
