Eslam-Abdo/16-bit_microprocessor/screen shoot/a-reg.jpg

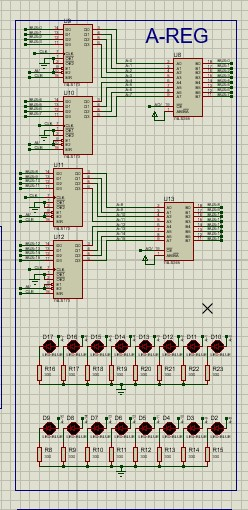
screen shoot/a-reg.jpg
