Eslam-Abdo/16-bit_microprocessor/screen shoot/bus.jpg

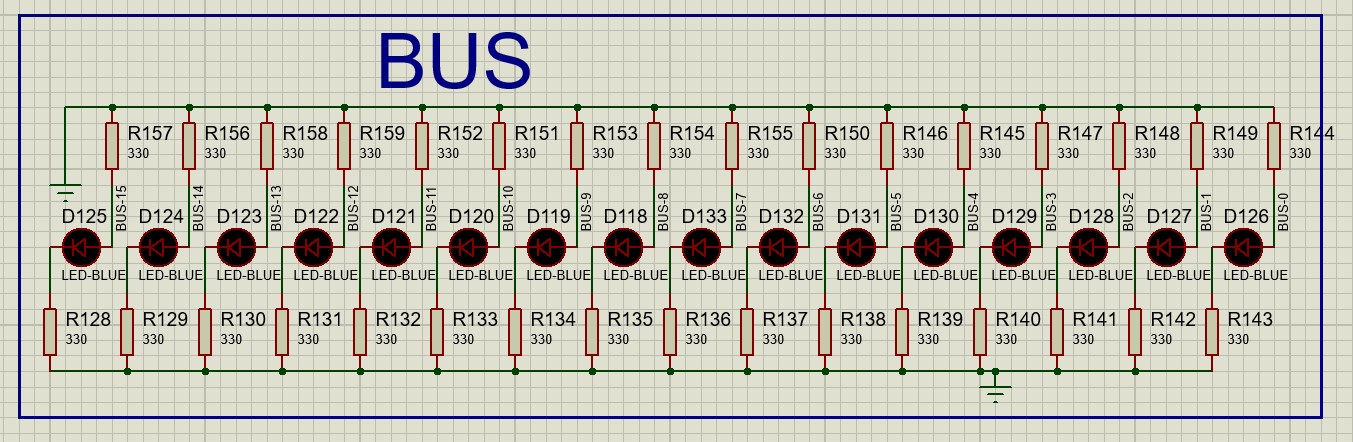
screen shoot/bus.jpg
