Eslam-Abdo/16-bit_microprocessor/screen shoot/ir.jpg

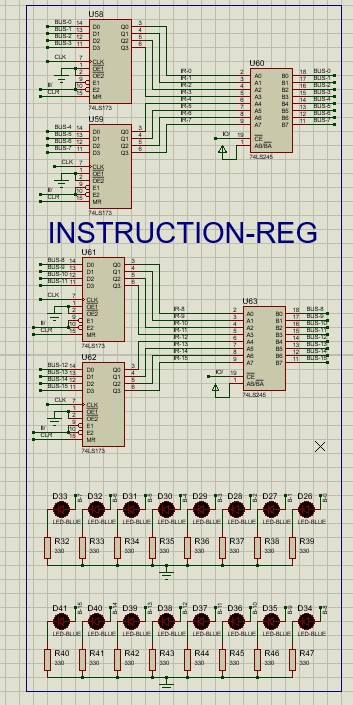
screen shoot/ir.jpg
