Eslam-Abdo/16-bit_microprocessor/(list of files, drawings)

Other design files:
simulation/PROSSECOR.pdsprj
